RacoonDOEggs/hw_microRusEfi_usb_c/micro_rusEFI.kicad_pcb

## KiCad design micro_rusEFI.kicad_pcb (2025-06-24)

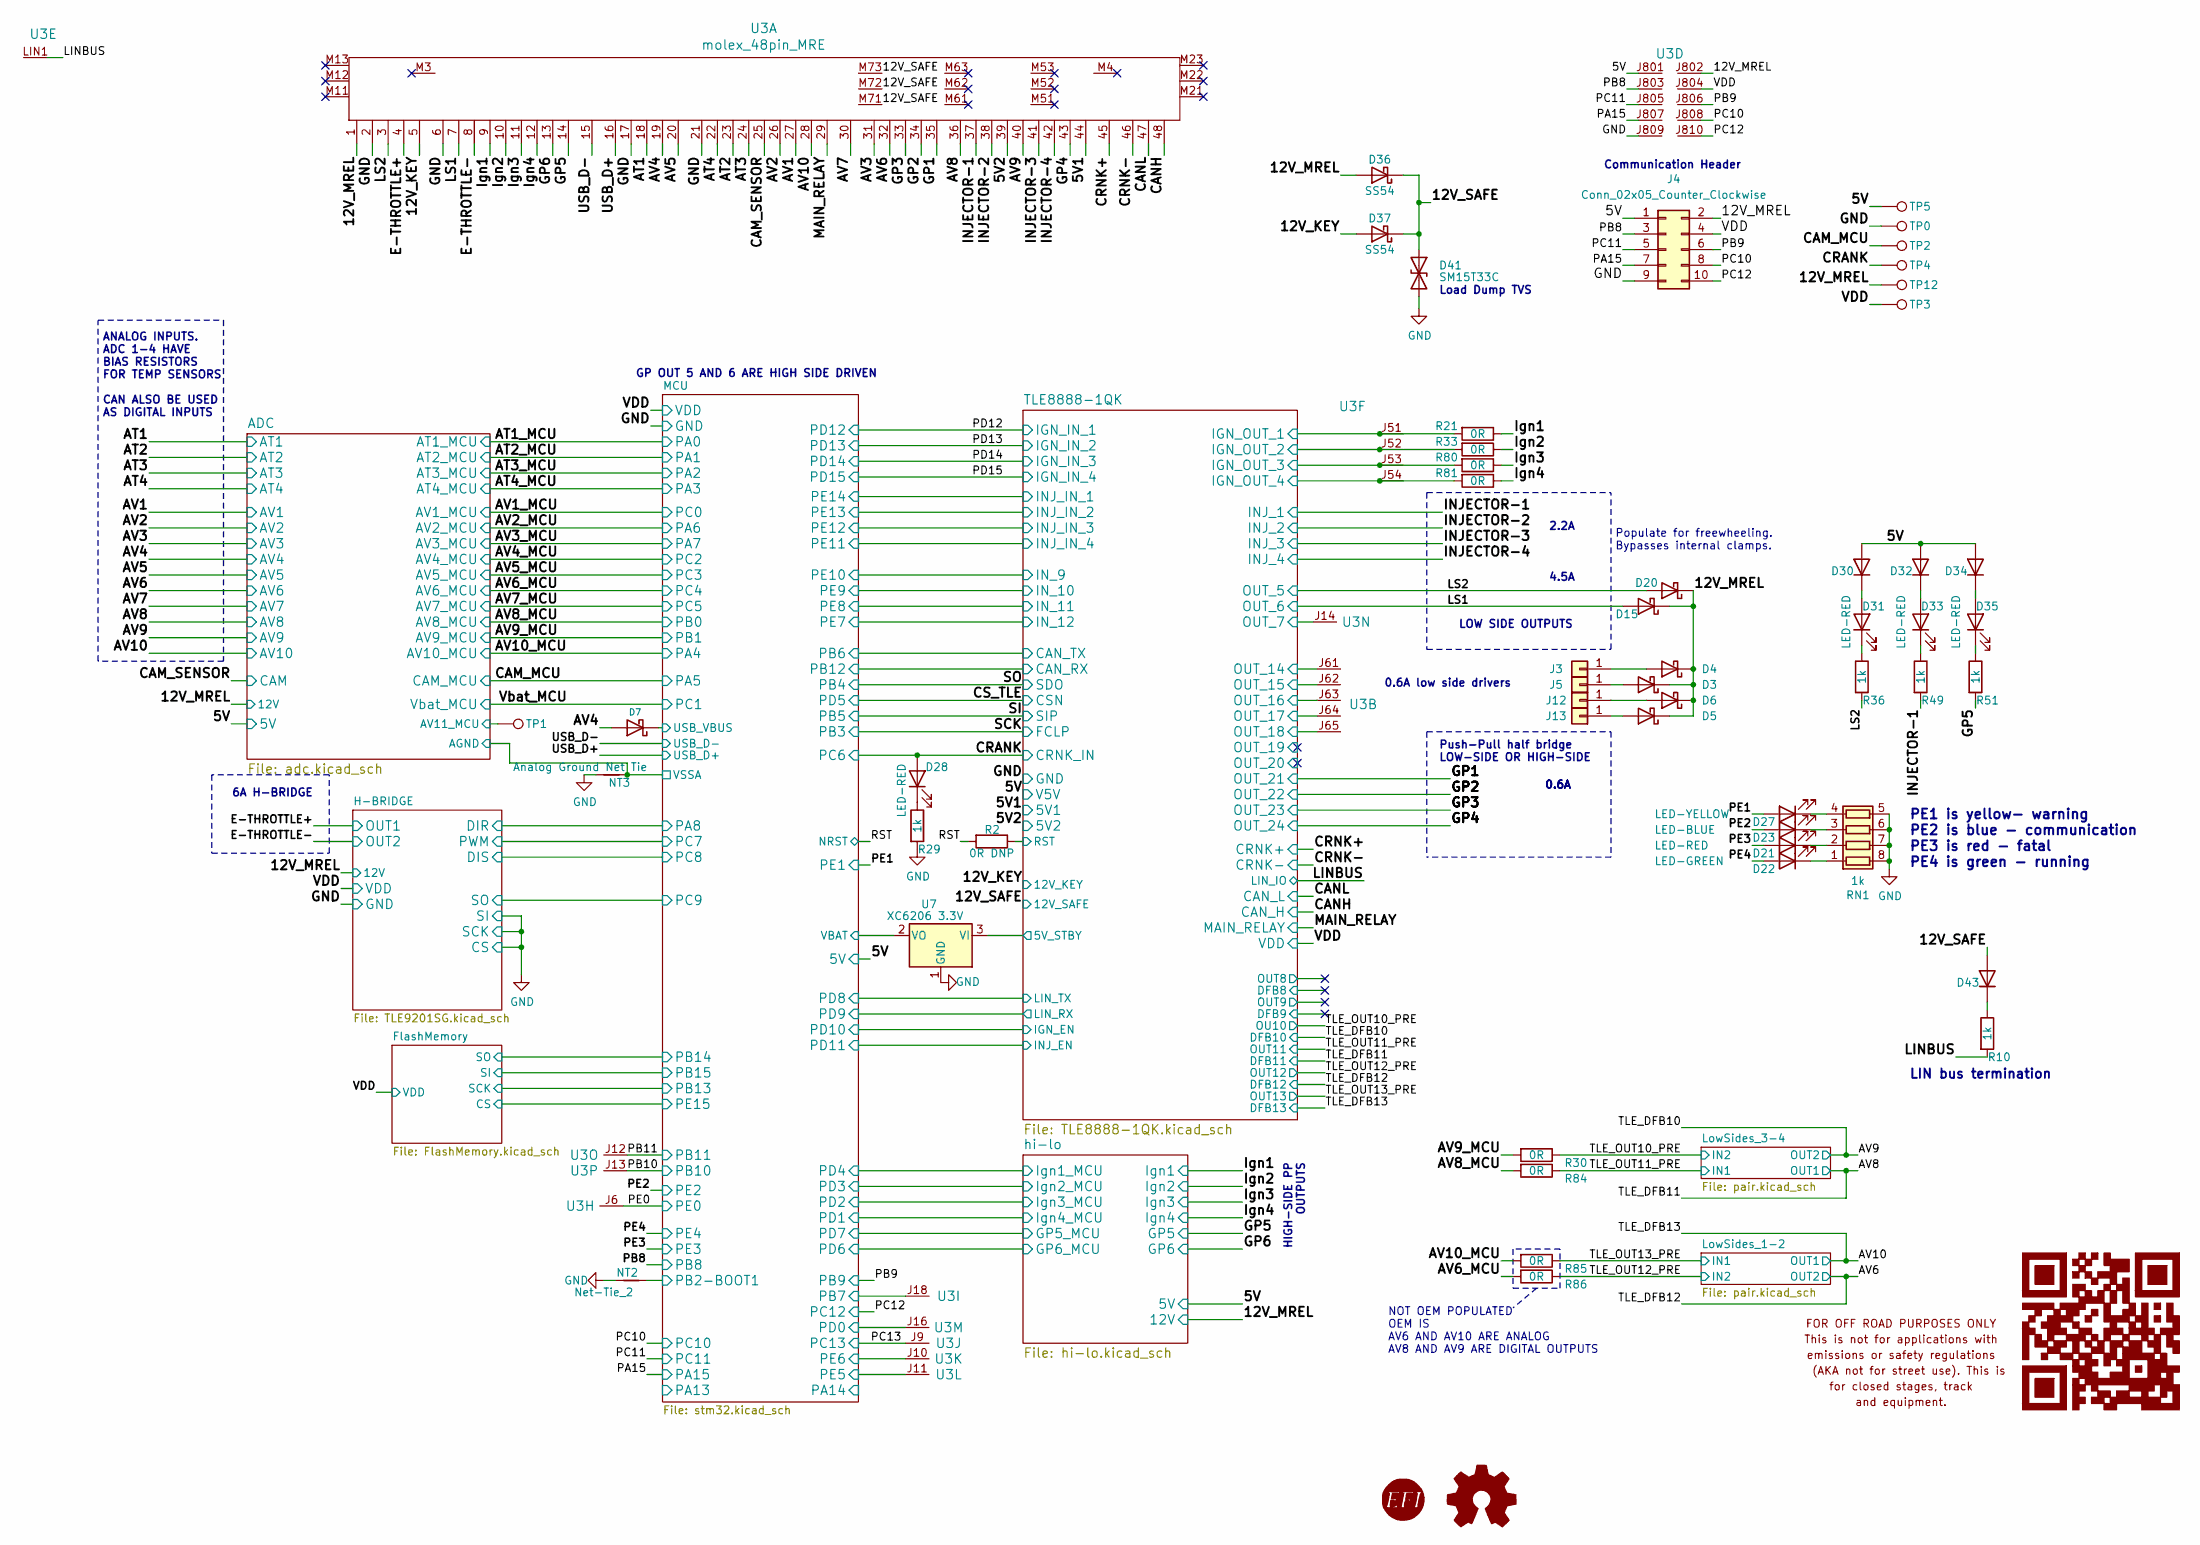
[picture p1: schematic micro_rusEFI.kicad_sch, microRusEFI-2L]

Parts:
D3, D4, D5, D6, D15, D20, D36, D37: SS54; D_SMA; LCSC C22452
D7: B5819W; D_SOD-123; LCSC C8598
D21: LED-RED; LED_0805_2012Metric; LCSC C84256
D22: LED-GREEN; LED_0805_2012Metric; LCSC C2297
D23: LED-BLUE; LED_0805_2012Metric; LCSC C2293
D27: LED-YELLOW; LED_0805_2012Metric; LCSC C2296
D28, D31, D33, D35: LED-RED; LED_0603_1608Metric; LCSC C2286
D30, D32, D34, D43: 1N4148WS; D_SOD-323; Part # NSR0530HT; LCSC C2128
D41: SM15T33C; D_SMC; LCSC C133707
G1: Disclaimer; Off_Road_Disclaimer
J3, J5, J12, J13: Conn_01x01; Pin_D0.7mm_L6.5mm_W1.8mm_FlatFork
J4: Conn_02x05_Counter_Clockwise; PinHeader_2x05_P2.54mm_Vertical_SMD
LOGO1: DNP; OSHW-Logo2_7.3x6mm_SilkScreen; Part # DNP
LOGO2: DNP; LOGO; Part # DNP
LOGO3: LOGO; MRE_QR_code
NT2: Net-Tie_2; Net-Tie_2_8.5mil
NT3: Analog Ground Net Tie; NetTie-2_SMD_Pad0.5mm
R2: 0R DNP; R_0603_1608Metric; Part # DNP
R10: 1k; R_1206_3216Metric; LCSC C4410
R21, R30, R33, R80, R81, R84: 0R; R_0603_1608Metric; Part # 0603WAF0000T5E; LCSC C21189
R29, R36, R49, R51: 1k; R_0603_1608Metric; Part # RMCF0603JJ1K00; LCSC C21190
R85: 0R; R_0603_1608Metric; Part # 0603WAF0000T5E
R86: 0R; R_0805_2012Metric
RN1: 1k; R_Array_Convex_4x0603; Part # CAT16-1001F4LF; LCSC C20197
TP0, TP3: GND; TestPoint_Pad_D2.0mm; Part # DNP
TP1, TP2, TP4: TP; TestPoint_Pad_D2.0mm; Part # DNP
TP5, TP12: 5V; TestPoint_Pad_D2.0mm; Part # DNP
U3: molex_48pin_MRE; Molex_48_MRE; Part # 500762-0481
U7: XC6206 3.3V; SOT-23; Part # XC6206P332MR; LCSC C5446

Connections:
/5V: D30.2 (A), D32.2 (A), D34.2 (A), J4.1, TP5.1, U3.J801; also elsewhere on the board
/5V1: U3.44; also elsewhere on the board
/5V2: U3.39; also elsewhere on the board
/12V_KEY: D37.2 (A), U3.5; also elsewhere on the board
/12V_MREL: D3.1 (K), D4.1 (K), D5.1 (K), D6.1 (K), D15.1 (K), D20.1 (K), D36.2 (A), J4.2, TP12.1, U3.1, U3.J802; also elsewhere on the board
/12V_SAFE: D36.1 (K), D37.1 (K), D41.1 (A1), D43.2 (A), U3.M71, U3.M72, U3.M73; also elsewhere on the board
/ADC/AGND: NT3.2; also elsewhere on the board
/ADC/AV11_MCU: TP1.1; also elsewhere on the board
/AT1: U3.18; also elsewhere on the board
/AT2: U3.23; also elsewhere on the board
/AT3: U3.24; also elsewhere on the board
/AT4: U3.22; also elsewhere on the board
/AV1: U3.27; also elsewhere on the board
/AV2: U3.26; also elsewhere on the board
/AV3: U3.31; also elsewhere on the board
/AV4: D7.2 (A), U3.19; also elsewhere on the board
/AV5: U3.20; also elsewhere on the board
/AV6: U3.32; also elsewhere on the board
/AV6_MCU: R86.2; also elsewhere on the board
/AV7: U3.30; also elsewhere on the board
/AV8: U3.36; also elsewhere on the board
/AV8_MCU: R84.2; also elsewhere on the board
/AV9: U3.40; also elsewhere on the board
/AV9_MCU: R30.2; also elsewhere on the board
/AV10: U3.28; also elsewhere on the board
/AV10_MCU: R85.2; also elsewhere on the board
/CAM_MCU: TP2.1; also elsewhere on the board
/CAM_SENSOR: U3.25; also elsewhere on the board
/CANH: U3.48; also elsewhere on the board
/CANL: U3.47; also elsewhere on the board
/CRANK: D28.2 (A), TP4.1; also elsewhere on the board
/CRNK+: U3.45; also elsewhere on the board
/CRNK-: U3.46; also elsewhere on the board
/E-THROTTLE+: U3.4; also elsewhere on the board
/E-THROTTLE-: U3.8; also elsewhere on the board
/GP1: U3.35; also elsewhere on the board
/GP2: U3.34; also elsewhere on the board
/GP3: U3.33; also elsewhere on the board
/GP4: U3.43; also elsewhere on the board
/GP5: R51.2, U3.14; also elsewhere on the board
/GP6: U3.13; also elsewhere on the board
/INJECTOR-1: R49.2, U3.37; also elsewhere on the board
/INJECTOR-2: U3.38; also elsewhere on the board
/INJECTOR-3: U3.41; also elsewhere on the board
/INJECTOR-4: U3.42; also elsewhere on the board
/Ign1: R21.1, U3.9; also elsewhere on the board
/Ign2: R33.1, U3.10; also elsewhere on the board
/Ign3: R80.1, U3.11; also elsewhere on the board
/Ign4: R81.1, U3.12; also elsewhere on the board
/LINBUS: R10.2, U3.LIN1; also elsewhere on the board
/LS1: D15.2 (A), U3.7; also elsewhere on the board
/LS2: D20.2 (A), R36.2, U3.3; also elsewhere on the board
/MAIN_RELAY: U3.29; also elsewhere on the board
/MCU/PB2-BOOT1: NT2.2; also elsewhere on the board
/MCU/PB7: U3.J18; also elsewhere on the board
/MCU/PD0: U3.J16; also elsewhere on the board
/MCU/PE5: U3.J11; also elsewhere on the board
/MCU/PE6: U3.J10; also elsewhere on the board
/MCU/VBAT: U7.2 (VO); also elsewhere on the board
/MCU/Vbus: D7.1 (K); also elsewhere on the board
/PA15: J4.7, U3.J807; also elsewhere on the board
/PB8: J4.3, U3.J803; also elsewhere on the board
/PB9: J4.6, U3.J806; also elsewhere on the board
/PB10: U3.J13; also elsewhere on the board
/PB11: U3.J12; also elsewhere on the board
/PC10: J4.8, U3.J808; also elsewhere on the board
/PC11: J4.5, U3.J805; also elsewhere on the board
/PC12: J4.10, U3.J810; also elsewhere on the board
/PC13: U3.J9; also elsewhere on the board
/PE0: U3.J6; also elsewhere on the board
/PE1: D27.2 (A); also elsewhere on the board
/PE2: D23.2 (A); also elsewhere on the board
/PE3: D21.2 (A); also elsewhere on the board
/PE4: D22.2 (A); also elsewhere on the board
/RST: R2.2; also elsewhere on the board
/TLE8888-1QK/5V_STBY: U7.3 (VI); also elsewhere on the board
/TLE8888-1QK/IGN_OUT_1: R21.2, U3.J51; also elsewhere on the board
/TLE8888-1QK/IGN_OUT_2: R33.2, U3.J52; also elsewhere on the board
/TLE8888-1QK/IGN_OUT_3: R80.2, U3.J53; also elsewhere on the board
/TLE8888-1QK/IGN_OUT_4: R81.2, U3.J54; also elsewhere on the board
/TLE8888-1QK/OUT_7: U3.J14; also elsewhere on the board
/TLE8888-1QK/OUT_14: U3.J61; also elsewhere on the board
/TLE8888-1QK/OUT_15: U3.J62; also elsewhere on the board
/TLE8888-1QK/OUT_16: U3.J63; also elsewhere on the board
/TLE8888-1QK/OUT_17: U3.J64; also elsewhere on the board
/TLE8888-1QK/OUT_18: U3.J65; also elsewhere on the board
/TLE8888-1QK/RST: R2.1; also elsewhere on the board
/TLE_OUT10_PRE: R30.1; also elsewhere on the board
/TLE_OUT11_PRE: R84.1; also elsewhere on the board
/TLE_OUT12_PRE: R86.1; also elsewhere on the board
/TLE_OUT13_PRE: R85.1; also elsewhere on the board
/USB_D+: U3.16; also elsewhere on the board
/USB_D-: U3.15; also elsewhere on the board
/VDD: J4.4, TP3.1, U3.J804; also elsewhere on the board
GND: D41.2 (A2), J4.9, NT2.1, NT3.1, R29.2, RN1.5 (R4.2), RN1.6 (R3.2), RN1.7 (R2.2), RN1.8 (R1.2), TP0.1, U3.2, U3.6, U3.17, U3.21, U3.J809, U7.1 (GND); also elsewhere on the board
unnamed: D3.2 (A), J5.1
unnamed: D4.2 (A), J3.1
unnamed: D5.2 (A), J13.1
unnamed: D6.2 (A), J12.1
unnamed: D21.1 (K), RN1.2 (R2.1)
unnamed: D22.1 (K), RN1.1 (R1.1)
unnamed: D23.1 (K), RN1.3 (R3.1)
unnamed: D27.1 (K), RN1.4 (R4.1)
unnamed: D28.1 (K), R29.1
unnamed: D30.1 (K), D31.2 (A)
unnamed: D31.1 (K), R36.1
unnamed: D32.1 (K), D33.2 (A)
unnamed: D33.1 (K), R49.1
unnamed: D34.1 (K), D35.2 (A)
unnamed: D35.1 (K), R51.1
unnamed: D43.1 (K), R10.1

Notes on the sheet:
GP OUT 5 AND 6 ARE HIGH SIDE DRIVEN
6A H-BRIDGE
Load Dump TVS
0.6A
0.6A low side drivers
NOT OEM POPULATED OEM IS AV6 AND AV10 ARE ANALOG AV8 AND AV9 ARE DIGITAL OUTPUTS
Communication Header
ANALOG INPUTS. ADC 1-4 HAVE BIAS RESISTORS FOR TEMP SENSORS CAN ALSO BE USED AS DIGITAL INPUTS
LOW SIDE OUTPUTS
Push-Pull half bridge LOW-SIDE OR HIGH-SIDE
4.5A
PE1 is yellow- warning PE2 is blue - communication PE3 is red - fatal PE4 is green - running
HIGH-SIDE PP OUTPUTS
Populate for freewheeling. Bypasses internal clamps.
2.2A
LIN bus termination

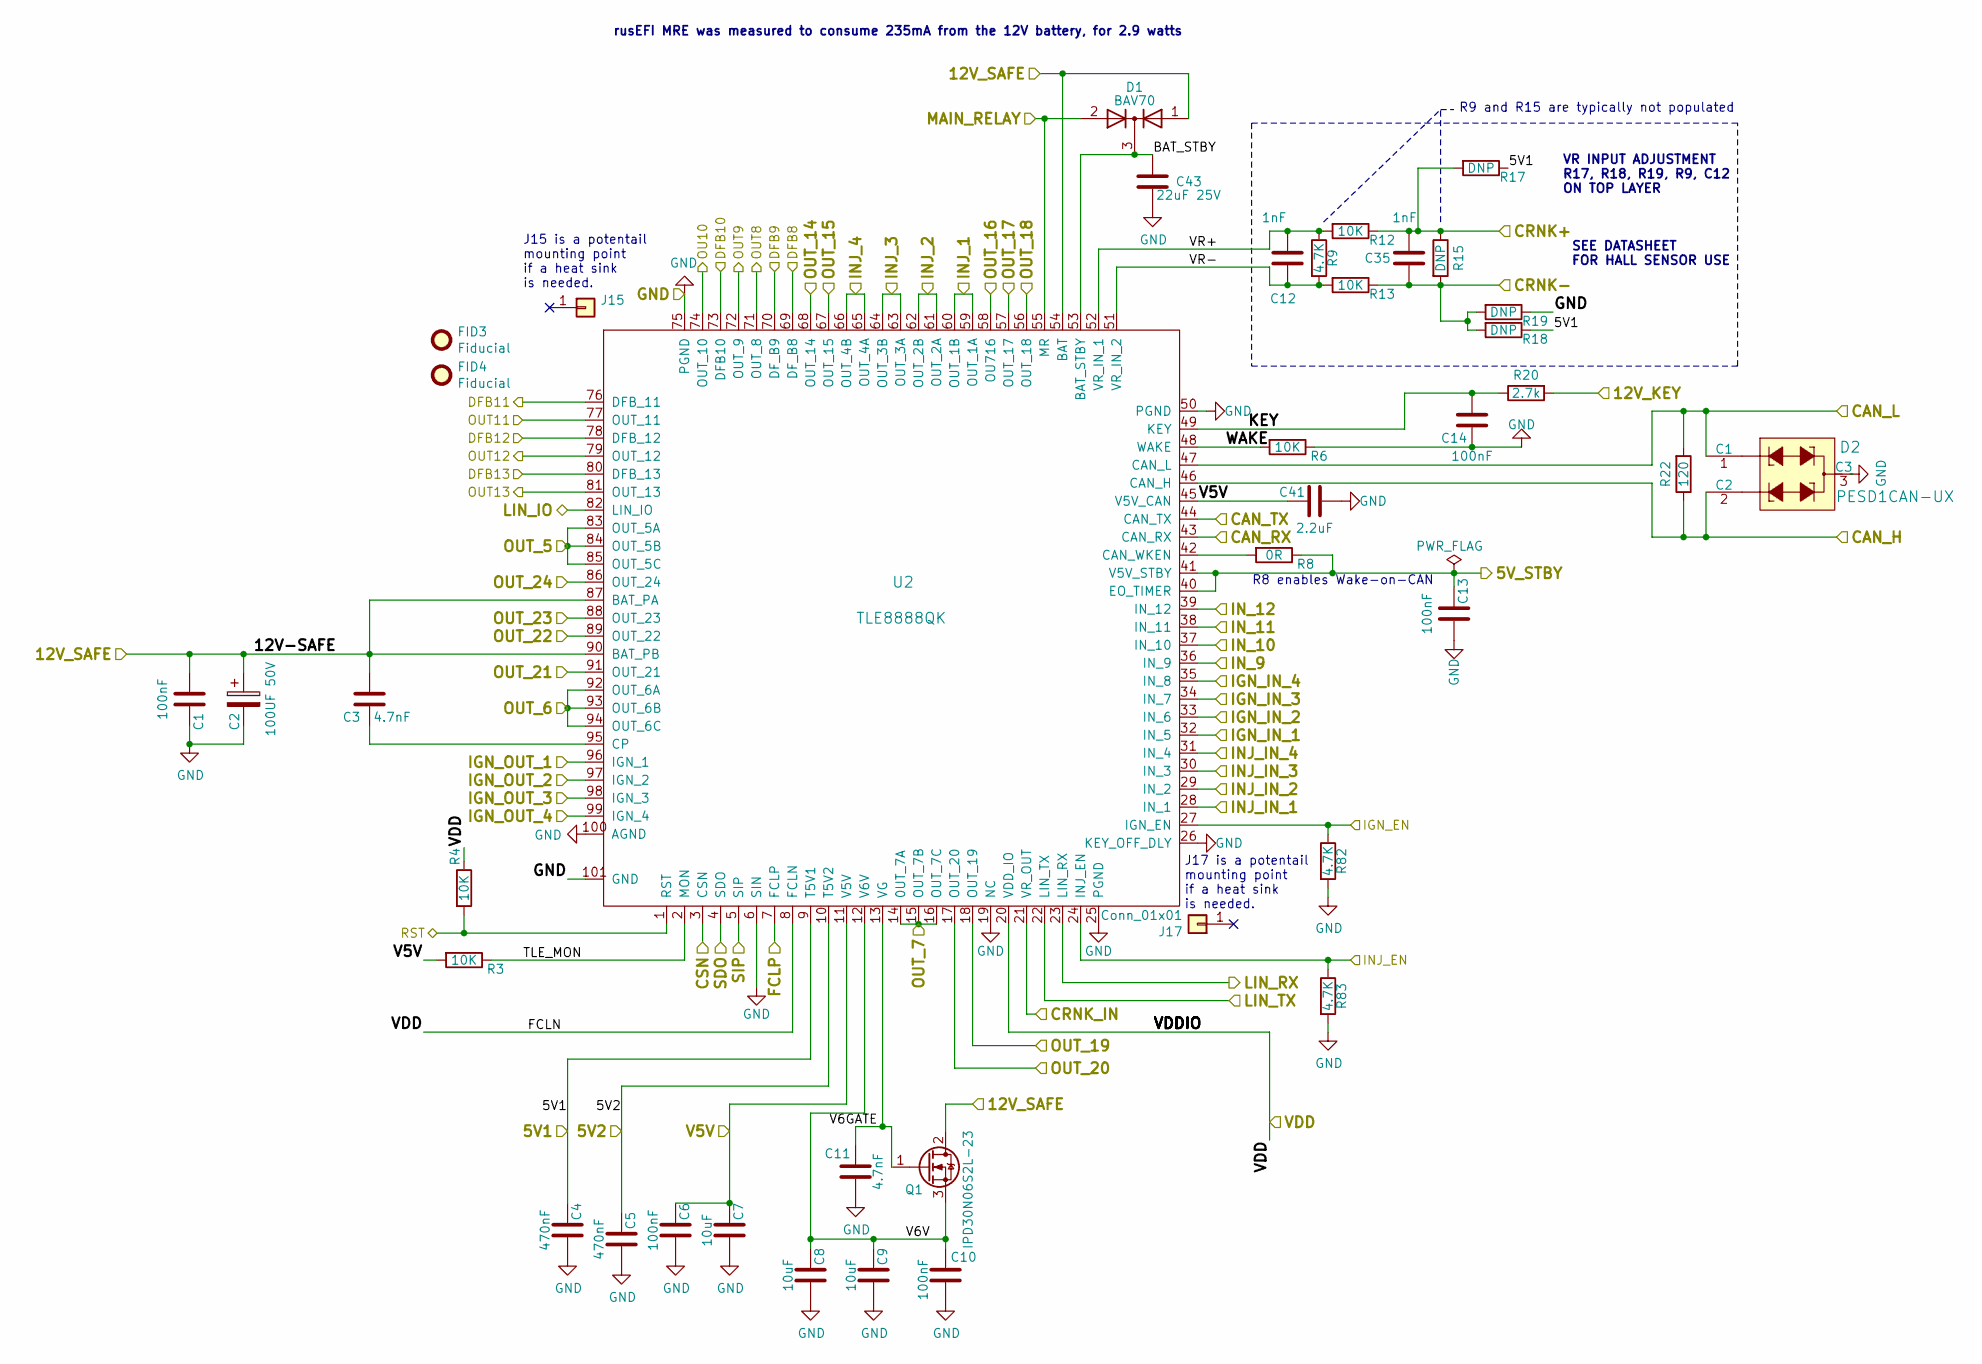
[picture p2: schematic TLE8888-1QK.kicad_sch, microRusEFI-2L]

Parts:
C1, C6, C10, C13, C14: 100nF; C_0603_1608Metric; Part # C0603C104J5RACTU; LCSC C14663
C2: 100UF 50V; CP_Elec_8x10.5; Part # UCD1H101MNL1GS; LCSC C134515
C3, C11: 4.7nF; C_0603_1608Metric; Part # CGA3E2X7R1H472K080AA; LCSC C53987
C4, C5: 470nF; C_0603_1608Metric; Part # CGA3E3X7R1H474K080AE; LCSC C1623
C7, C8, C9: 10uF; C_0603_1608Metric; Part # C1608X5R1E106M080AC; LCSC C19702
C12, C35: 1nF; C_0603_1608Metric; Part # GRM1885C1H102FA01D; LCSC C1588
C41: 2.2uF; C_0603_1608Metric; Part # GRM188R6YA225KA12D; LCSC C23630
C43: 22uF 25V; C_0805_2012Metric; Part # CL21A226MAQNNNE; LCSC C45783
D1: BAV70; SOT-23; LCSC C82479
D2: PESD1CAN-UX; SOT-23; Part # PESD1CANUX; LCSC C152727
FID3, FID4: Fiducial; Fiducial_0.5mm_Mask1mm; Part # DNP
J15, J17: Conn_01x01; Pin_D0.7mm_L6.5mm_W1.8mm_FlatFork
Q1: IPD30N06S2L-23; TO-252-2; Part # IPD30N06S2L23AT3; LCSC C3010
R3: 10K; R_0805_2012Metric; LCSC C17414
R4, R6, R12, R13: 10K; R_0603_1608Metric; Part # RMCF0603JT10K0; LCSC C25804
R8: 0R; R_0603_1608Metric; Part # 0603WAF0000T5E; LCSC C21189
R9: 4.7K; R_0603_1608Metric; Part # RMCF0603JT4K70; LCSC DNP
R15, R17, R18, R19: DNP; R_0603_1608Metric; Part # DNP
R20: 2.7k; R_0603_1608Metric; Part # RMCF0603FT2K70; LCSC C13167
R22: 120; R_0805_2012Metric; LCSC C17437
R82, R83: 4.7K; R_0603_1608Metric; Part # RMCF0603JT4K70; LCSC C23162
U2: TLE8888QK; LQFP-100_14x14mm_P0.5mm_THERMAL; Part # TLE88882QKXUMA1

Connections:
/5V: C6.1, C7.1, C41.1, R3.2, U2.11 (V5V), U2.45 (V5V_CAN); also elsewhere on the board
/5V1: C4.1, R17.1, R18.1, U2.9 (T5V1); also elsewhere on the board
/5V2: C5.1, U2.10 (T5V2); also elsewhere on the board
/12V_KEY: R20.2; also elsewhere on the board
/12V_SAFE: C1.1, C2.1, C3.1, D1.1 (A), Q1.2 (D), U2.54 (BAT), U2.87 (BAT_PA), U2.90 (BAT_PB); also elsewhere on the board
/AV6: U2.78 (DFB_12); also elsewhere on the board
/AV8: U2.76 (DFB_11); also elsewhere on the board
/AV9: U2.73 (DFB10); also elsewhere on the board
/AV10: U2.80 (DFB_13); also elsewhere on the board
/CANH: D2.2 (C2), R22.1, U2.46 (CAN_H); also elsewhere on the board
/CANL: D2.1 (C1), R22.2, U2.47 (CAN_L); also elsewhere on the board
/CRANK: U2.21 (VR_OUT); also elsewhere on the board
/CRNK+: C35.1, R12.1, R15.1, R17.2; also elsewhere on the board
/CRNK-: C35.2, R13.1, R15.2, R18.2, R19.2; also elsewhere on the board
/CS_TLE: U2.3 (CSN); also elsewhere on the board
/GP1: U2.91 (OUT_21); also elsewhere on the board
/GP2: U2.89 (OUT_22); also elsewhere on the board
/GP3: U2.88 (OUT_23); also elsewhere on the board
/GP4: U2.86 (OUT_24); also elsewhere on the board
/INJECTOR-1: U2.59 (OUT_1A), U2.60 (OUT_1B); also elsewhere on the board
/INJECTOR-2: U2.61 (OUT_2A), U2.62 (OUT_2B); also elsewhere on the board
/INJECTOR-3: U2.63 (OUT_3A), U2.64 (OUT_3B); also elsewhere on the board
/INJECTOR-4: U2.65 (OUT_4A), U2.66 (OUT_4B); also elsewhere on the board
/LINBUS: U2.82 (LIN_IO); also elsewhere on the board
/LS1: U2.92 (OUT_6A), U2.93 (OUT_6B), U2.94 (OUT_6C); also elsewhere on the board
/LS2: U2.83 (OUT_5A), U2.84 (OUT_5B), U2.85 (OUT_5C); also elsewhere on the board
/MAIN_RELAY: D1.2 (A), U2.55 (MR); also elsewhere on the board
/MCU/PB6: U2.44 (CAN_TX); also elsewhere on the board
/MCU/PB12: U2.43 (CAN_RX); also elsewhere on the board
/MCU/PD8: U2.22 (LIN_TX); also elsewhere on the board
/MCU/PD9: U2.23 (LIN_RX); also elsewhere on the board
/MCU/PD10: R82.1, U2.27 (IGN_EN); also elsewhere on the board
/MCU/PD11: R83.1, U2.24 (INJ_EN); also elsewhere on the board
/MCU/PE7: U2.39 (IN_12); also elsewhere on the board
/MCU/PE8: U2.38 (IN_11); also elsewhere on the board
/MCU/PE9: U2.37 (IN_10); also elsewhere on the board
/MCU/PE10: U2.36 (IN_9); also elsewhere on the board
/MCU/PE11: U2.31 (IN_4); also elsewhere on the board
/MCU/PE12: U2.30 (IN_3); also elsewhere on the board
/MCU/PE13: U2.29 (IN_2); also elsewhere on the board
/MCU/PE14: U2.28 (IN_1); also elsewhere on the board
/PD12: U2.32 (IN_5); also elsewhere on the board
/PD13: U2.33 (IN_6); also elsewhere on the board
/PD14: U2.34 (IN_7); also elsewhere on the board
/PD15: U2.35 (IN_8); also elsewhere on the board
/SCK: U2.7 (FCLP); also elsewhere on the board
/SI: U2.5 (SIP); also elsewhere on the board
/SO: U2.4 (SDO); also elsewhere on the board
/TLE8888-1QK/5V_STBY: C13.1, R8.1, U2.40 (EO_TIMER), U2.41 (V5V_STBY); also elsewhere on the board
/TLE8888-1QK/BAT_STBY: C43.1, D1.3 (K), U2.53 (BAT_STBY)
/TLE8888-1QK/DFB8: U2.69 (DF_B8)
/TLE8888-1QK/DFB9: U2.70 (DF_B9)
/TLE8888-1QK/IGN_OUT_1: U2.96 (IGN_1); also elsewhere on the board
/TLE8888-1QK/IGN_OUT_2: U2.97 (IGN_2); also elsewhere on the board
/TLE8888-1QK/IGN_OUT_3: U2.98 (IGN_3); also elsewhere on the board
/TLE8888-1QK/IGN_OUT_4: U2.99 (IGN_4); also elsewhere on the board
/TLE8888-1QK/KEY: C14.1, R20.1, U2.49 (KEY)
/TLE8888-1QK/OUT8: U2.71 (OUT_8)
/TLE8888-1QK/OUT9: U2.72 (OUT_9)
/TLE8888-1QK/OUT_7: U2.14 (0UT_7A), U2.15 (OUT_7B), U2.16 (OUT_7C); also elsewhere on the board
/TLE8888-1QK/OUT_14: U2.68 (OUT_14); also elsewhere on the board
/TLE8888-1QK/OUT_15: U2.67 (OUT_15); also elsewhere on the board
/TLE8888-1QK/OUT_16: U2.58 (OU716); also elsewhere on the board
/TLE8888-1QK/OUT_17: U2.57 (OUT_17); also elsewhere on the board
/TLE8888-1QK/OUT_18: U2.56 (OUT_18); also elsewhere on the board
/TLE8888-1QK/OUT_19: U2.18 (OUT_19)
/TLE8888-1QK/OUT_20: U2.17 (OUT_20)
/TLE8888-1QK/RST: R4.2, U2.1 (RST); also elsewhere on the board
/TLE8888-1QK/TLE_MON: R3.1, U2.2 (MON)
/TLE8888-1QK/V6GATE: C11.1, Q1.1 (G), U2.13 (VG)
/TLE8888-1QK/V6V: C8.1, C9.1, C10.1, Q1.3 (S), U2.12 (V6V)
/TLE8888-1QK/VR+: C12.1, R9.1, R12.2, U2.52 (VR_IN_1)
/TLE8888-1QK/VR-: C12.2, R9.2, R13.2, U2.51 (VR_IN_2)
/TLE8888-1QK/WAKE: R6.2, U2.48 (WAKE)
/TLE_OUT10_PRE: U2.74 (OUT_10); also elsewhere on the board
/TLE_OUT11_PRE: U2.77 (OUT_11); also elsewhere on the board
/TLE_OUT12_PRE: U2.79 (OUT_12); also elsewhere on the board
/TLE_OUT13_PRE: U2.81 (OUT_13); also elsewhere on the board
/VDD: R4.1, U2.8 (FCLN), U2.20 (VDD_IO); also elsewhere on the board
GND: C1.2, C2.2, C4.2, C5.2, C6.2, C7.2, C8.2, C9.2, C10.2, C11.2, C13.2, C14.2, C41.2, C43.2, D2.3 (C3), R6.1, R19.1, R82.2, R83.2, U2.6 (SIN), U2.19 (NC), U2.25 (PGND), U2.26 (KEY_OFF_DLY), U2.50 (PGND), U2.75 (PGND), U2.100 (AGND), U2.101 (GND); also elsewhere on the board
unnamed: R8.2, U2.42 (CAN_WKEN)
unnamed: C3.2, U2.95 (CP)

Notes on the sheet:
J15 is a potentail mounting point if a heat sink is needed.
rusEFI MRE was measured to consume 235mA from the 12V battery, for 2.9 watts
J17 is a potentail mounting point if a heat sink is needed.
R8 enables Wake-on-CAN
R9 and R15 are typically not populated
VR INPUT ADJUSTMENT R17, R18, R19, R9, C12 ON TOP LAYER
SEE DATASHEET FOR HALL SENSOR USE

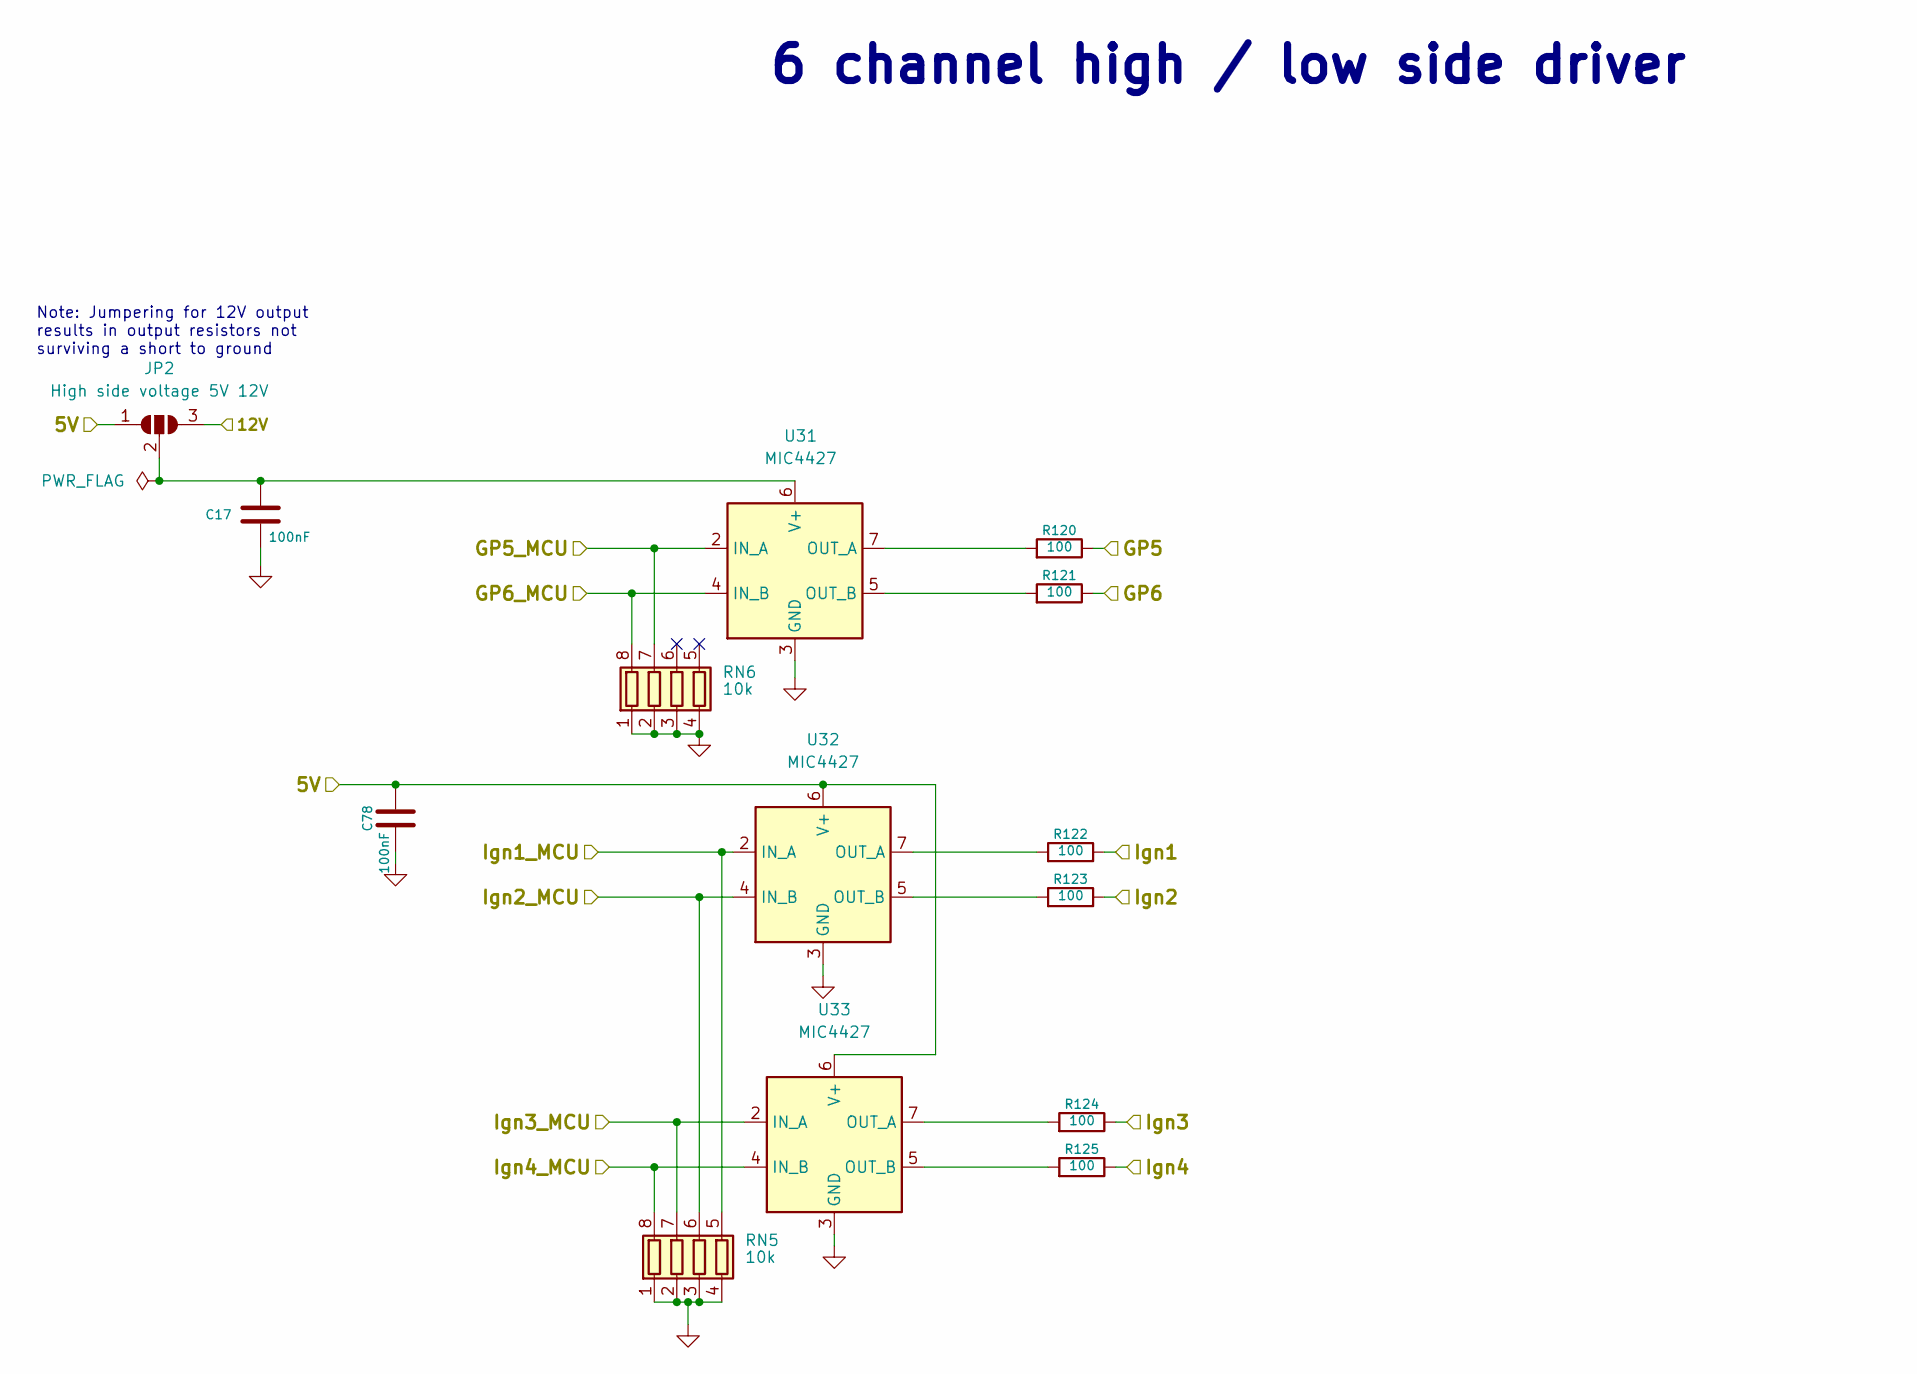
[picture p3: schematic hi-lo.kicad_sch, microRusEFI-2L]

Parts:
C17, C78: 100nF; C_0603_1608Metric; Part # C0603C104J5RACTU; LCSC C14663
JP2: High side voltage 5V 12V; SolderJumper-3_P1.3mm_Open_Pad1.0x1.5mm
R120, R121, R122, R123, R124, R125: 100; R_1206_3216Metric; Part # RMCF0603FT100R; LCSC C17901
RN5, RN6: 10k; R_Array_Convex_4x0603; Part # YC164-JR-0710KL; LCSC C29718
U31, U32, U33: MIC4427; SOIC-8_3.9x4.9mm_P1.27mm; LCSC C144205

Connections:
/5V: C78.1, JP2.1 (A), U32.6 (V+), U33.6 (V+); also elsewhere on the board
/12V_MREL: JP2.3 (B); also elsewhere on the board
/GP5: R120.1; also elsewhere on the board
/GP6: R121.1; also elsewhere on the board
/Ign1: R122.1; also elsewhere on the board
/Ign2: R123.1; also elsewhere on the board
/Ign3: R124.1; also elsewhere on the board
/Ign4: R125.1; also elsewhere on the board
/MCU/PD1: RN5.8 (R1.2), U33.4 (IN_B); also elsewhere on the board
/MCU/PD2: RN5.7 (R2.2), U33.2 (IN_A); also elsewhere on the board
/MCU/PD3: RN5.6 (R3.2), U32.4 (IN_B); also elsewhere on the board
/MCU/PD4: RN5.5 (R4.2), U32.2 (IN_A); also elsewhere on the board
/MCU/PD6: RN6.8 (R1.2), U31.4 (IN_B); also elsewhere on the board
/MCU/PD7: RN6.7 (R2.2), U31.2 (IN_A); also elsewhere on the board
GND: C17.2, C78.2, RN5.1 (R1.1), RN5.2 (R2.1), RN5.3 (R3.1), RN5.4 (R4.1), RN6.1 (R1.1), RN6.2 (R2.1), RN6.3 (R3.1), RN6.4 (R4.1), U31.3 (GND), U32.3 (GND), U33.3 (GND); also elsewhere on the board
unnamed: C17.1, JP2.2 (C), U31.6 (V+)
unnamed: R120.2, U31.7 (OUT_A)
unnamed: R121.2, U31.5 (OUT_B)
unnamed: R122.2, U32.7 (OUT_A)
unnamed: R123.2, U32.5 (OUT_B)
unnamed: R124.2, U33.7 (OUT_A)
unnamed: R125.2, U33.5 (OUT_B)

Notes on the sheet:
Note: Jumpering for 12V output results in output resistors not surviving a short to ground
6 channel high / low side driver
