RacoonDOEggs/hw_microRusEfi_usb_c/micro_rusEFI.kicad_pcb

## KiCad design micro_rusEFI.kicad_pcb (continued)

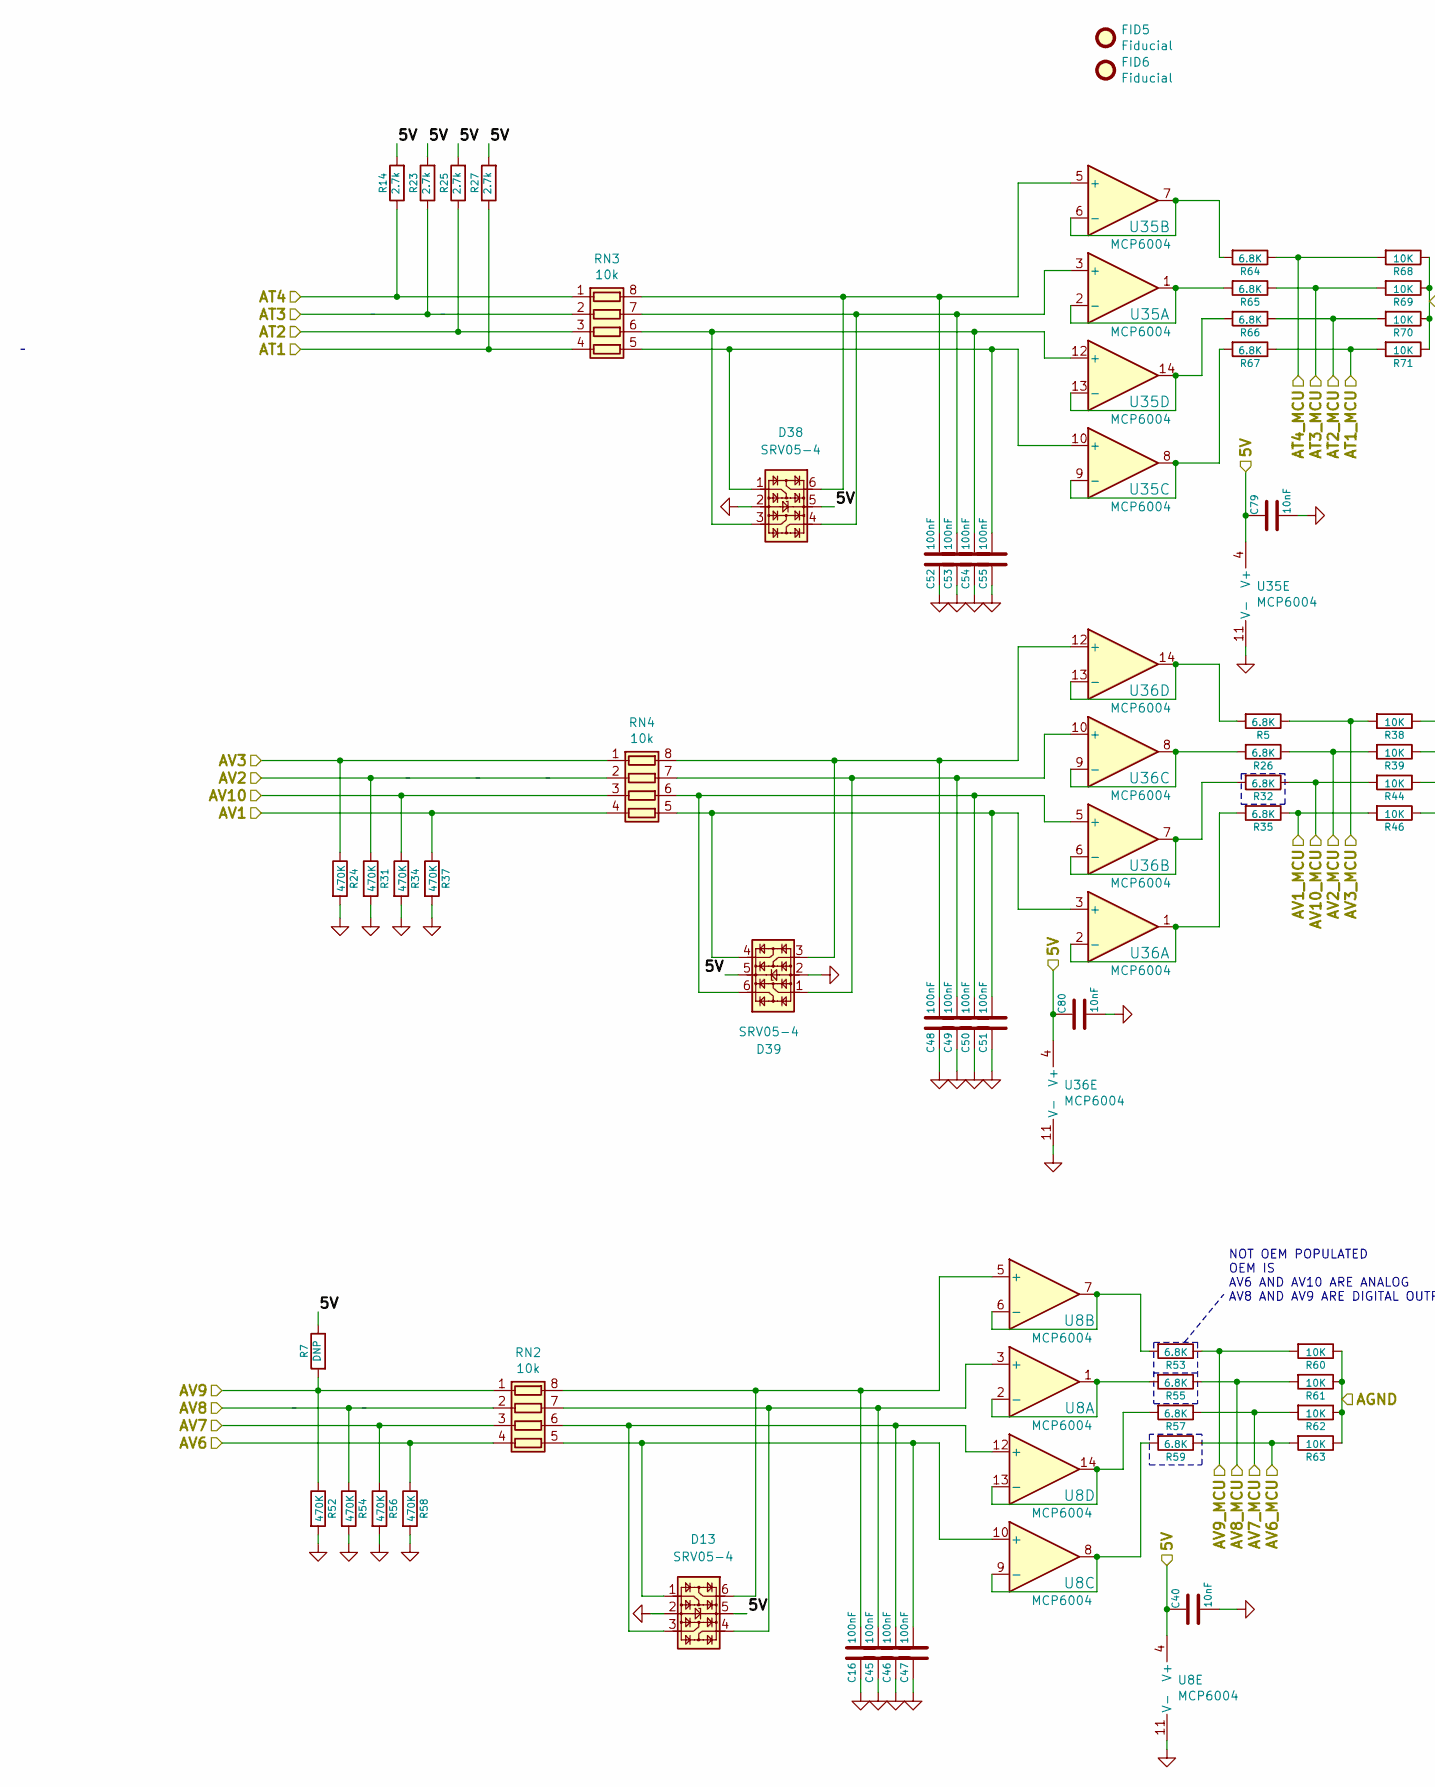
[picture p4: schematic adc.kicad_sch, microRusEFI-2L, part in row 1, column 1]

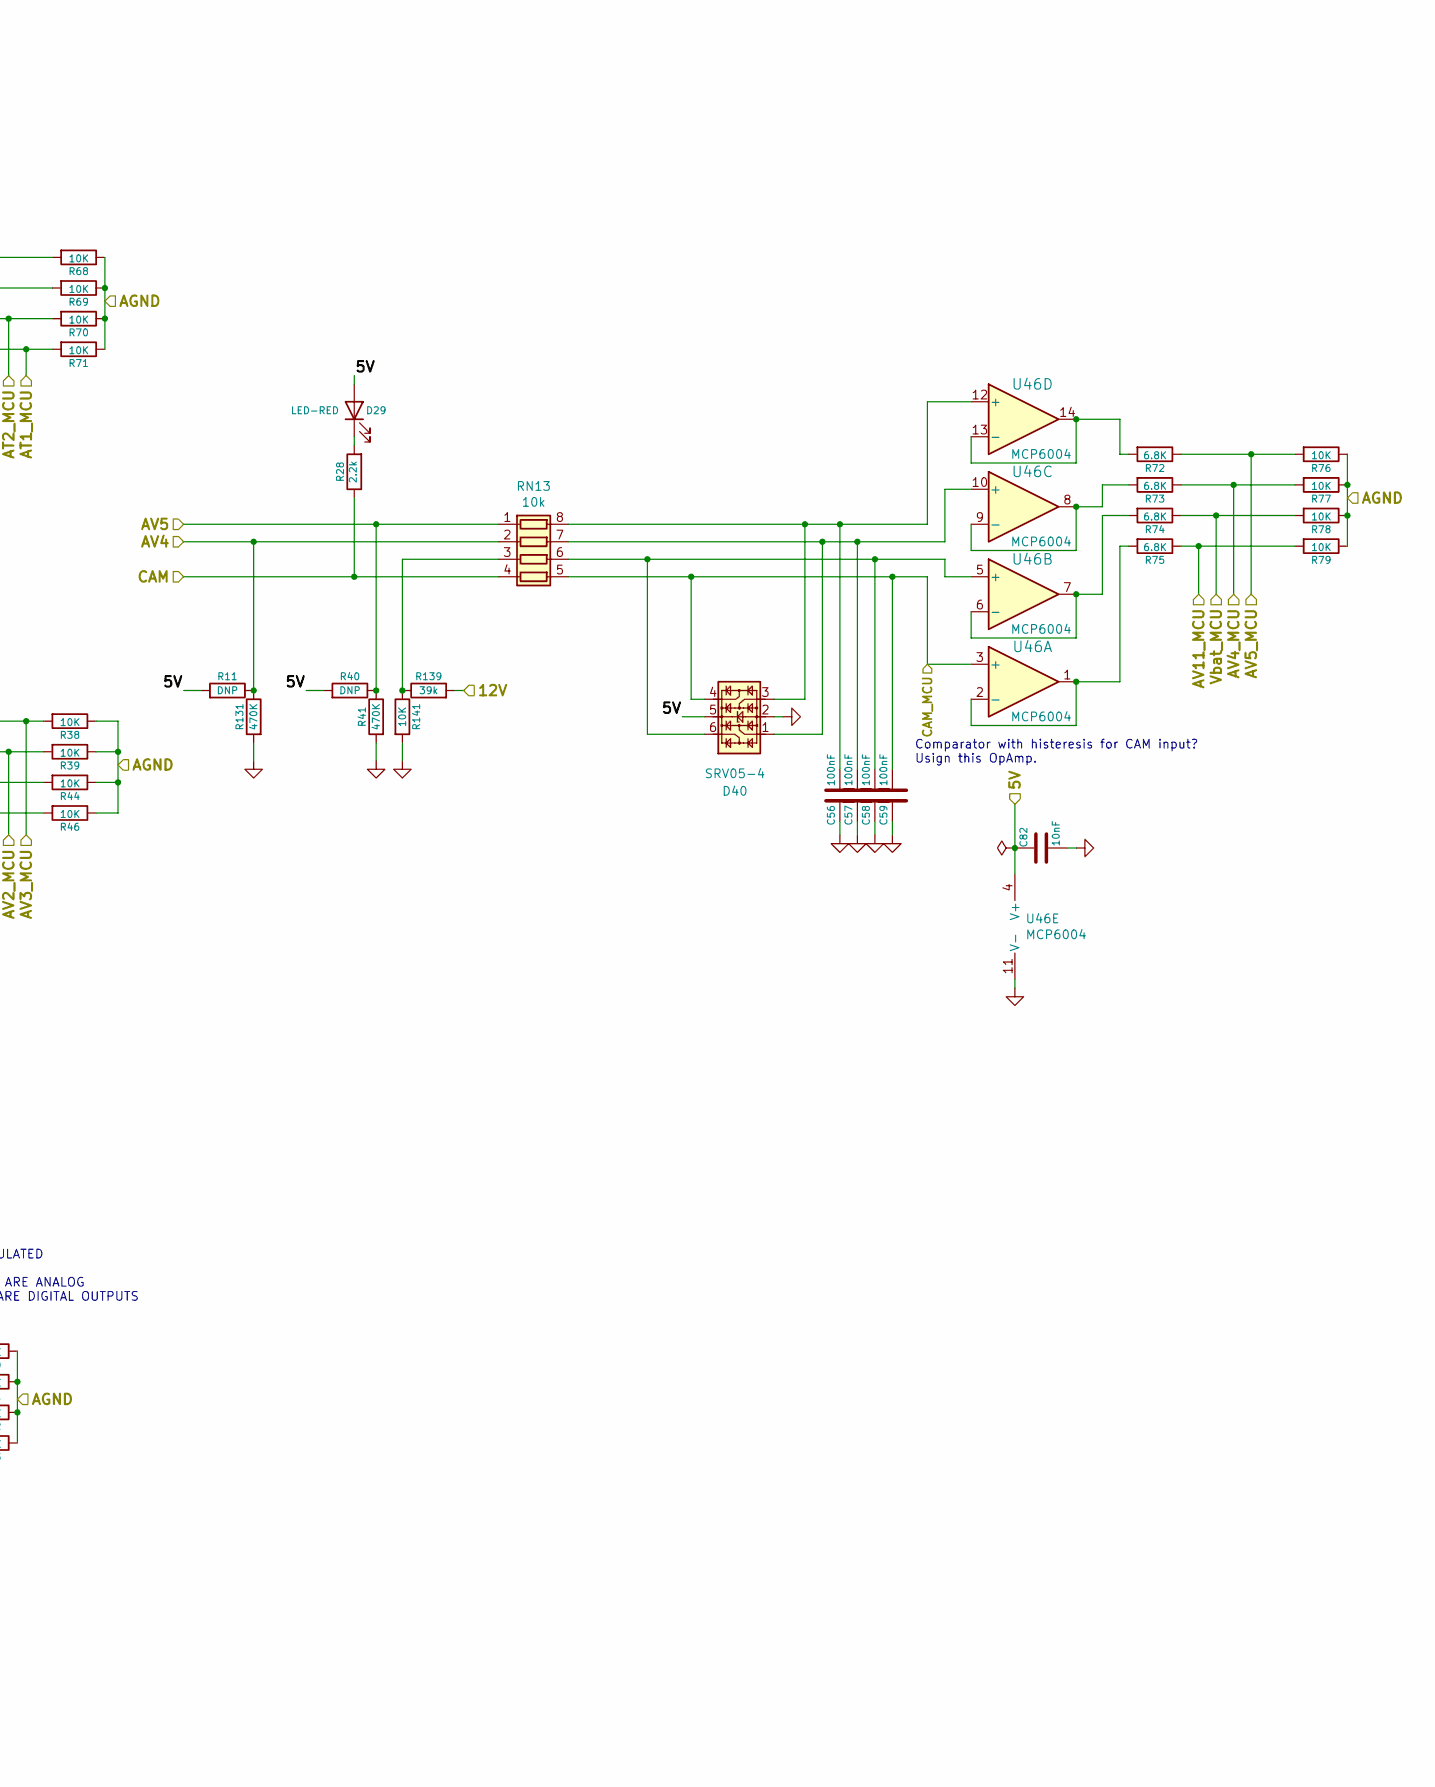
[picture p5: schematic adc.kicad_sch, microRusEFI-2L, part in row 1, column 2]

Parts:
C16, C45, C46, C47, C48, C49, C50, C51, C52, C53, C54, C55, C56, C57, C58, C59: 100nF; C_0402_1005Metric; LCSC C1525
C40, C79, C80, C82: 10nF; C_0603_1608Metric; Part # C0603C103K1RACTU; LCSC C57112
D13, D38, D39, D40: SRV05-4; SOT-23-6; LCSC C85364
D29: LED-RED; LED_0603_1608Metric; LCSC C2286
FID5, FID6: Fiducial; Fiducial_0.5mm_Mask1mm; Part # DNP
R5, R26, R32, R35, R57, R59, R64, R65, R66, R67, R72, R73, R74, R75: 6.8K; R_0603_1608Metric; LCSC C23212
R7, R11, R40: DNP; R_0402_1005Metric; Part # DNP
R14, R23, R25, R27: 2.7k; R_0603_1608Metric; Part # RMCF0603FT2K70; LCSC C13167
R24, R31, R34, R37, R41, R52, R54, R56, R58, R131: 470K; R_0402_1005Metric; LCSC C25790
R28: 2.2k; R_0603_1608Metric; Part # RMCF0603FT2K20; LCSC C4190
R38, R39, R44, R46, R60, R61, R62, R63, R68, R69, R70, R71, R76, R77, R78, R79, R141: 10K; R_0603_1608Metric; Part # RMCF0603JT10K0; LCSC C25804
R53, R55: 6.8K; R_0603_1608Metric
R139: 39k; R_0603_1608Metric; Part # RC0603FR-0739KL; LCSC C23153
RN2, RN3, RN4, RN13: 10k; R_Array_Convex_4x0603; Part # YC164-JR-0710KL; LCSC C29718
U8, U35, U36, U46: MCP6004; TSSOP-14_4.4x5mm_P0.65mm; Part # MCP6004T-I/ST; LCSC C248577

Connections:
/5V: C40.1, C79.1, C80.1, C82.1, D13.5, D29.2 (A), D38.5, D39.5, D40.5, R7.1, R11.2, R14.2, R23.2, R25.2, R27.2, R40.2, U8.4 (V+), U35.4 (V+), U36.4 (V+), U46.4 (V+); also elsewhere on the board
/12V_MREL: R139.2; also elsewhere on the board
/ADC/AGND: R38.1, R39.1, R44.1, R46.1, R60.1, R61.1, R62.1, R63.1, R68.1, R69.1, R70.1, R71.1, R76.1, R77.1, R78.1, R79.1; also elsewhere on the board
/ADC/AV11_MCU: R75.1, R79.2; also elsewhere on the board
/AT1: R27.1, RN3.4 (R4.1); also elsewhere on the board
/AT1_MCU: R67.1, R71.2; also elsewhere on the board
/AT2: R25.1, RN3.3 (R3.1); also elsewhere on the board
/AT2_MCU: R66.1, R70.2; also elsewhere on the board
/AT3: R23.1, RN3.2 (R2.1); also elsewhere on the board
/AT3_MCU: R65.1, R69.2; also elsewhere on the board
/AT4: R14.1, RN3.1 (R1.1); also elsewhere on the board
/AT4_MCU: R64.1, R68.2; also elsewhere on the board
/AV1: R37.1, RN4.4 (R4.1); also elsewhere on the board
/AV1_MCU: R35.1, R46.2; also elsewhere on the board
/AV2: R31.1, RN4.2 (R2.1); also elsewhere on the board
/AV2_MCU: R26.1, R39.2; also elsewhere on the board
/AV3: R24.1, RN4.1 (R1.1); also elsewhere on the board
/AV3_MCU: R5.1, R38.2; also elsewhere on the board
/AV4: R11.1, R131.1, RN13.2 (R2.1); also elsewhere on the board
/AV4_MCU: R73.1, R77.2; also elsewhere on the board
/AV5: R40.1, R41.1, RN13.1 (R1.1); also elsewhere on the board
/AV5_MCU: R72.1, R76.2; also elsewhere on the board
/AV6: R58.1, RN2.4 (R4.1); also elsewhere on the board
/AV6_MCU: R59.1, R63.2; also elsewhere on the board
/AV7: R56.1, RN2.3 (R3.1); also elsewhere on the board
/AV7_MCU: R57.1, R62.2; also elsewhere on the board
/AV8: R54.1, RN2.2 (R2.1); also elsewhere on the board
/AV8_MCU: R55.1, R61.2; also elsewhere on the board
/AV9: R7.2, R52.1, RN2.1 (R1.1); also elsewhere on the board
/AV9_MCU: R53.1, R60.2; also elsewhere on the board
/AV10: R34.1, RN4.3 (R3.1); also elsewhere on the board
/AV10_MCU: R32.1, R44.2; also elsewhere on the board
/CAM_MCU: C59.1, D40.4, RN13.5 (R4.2), U46.3 (+); also elsewhere on the board
/CAM_SENSOR: R28.1, RN13.4 (R4.1); also elsewhere on the board
/Vbat_MCU: R74.1, R78.2; also elsewhere on the board
GND: C16.2, C40.2, C45.2, C46.2, C47.2, C48.2, C49.2, C50.2, C51.2, C52.2, C53.2, C54.2, C55.2, C56.2, C57.2, C58.2, C59.2, C79.2, C80.2, C82.2, D13.2, D38.2, D39.2, D40.2, R24.2, R31.2, R34.2, R37.2, R41.2, R52.2, R54.2, R56.2, R58.2, R131.2, R141.2, U8.11 (V-), U35.11 (V-), U36.11 (V-), U46.11 (V-); also elsewhere on the board
unnamed: D29.1 (K), R28.2
unnamed: C16.1, D13.6, RN2.8 (R1.2), U8.5 (+)
unnamed: C45.1, D13.4, RN2.7 (R2.2), U8.3 (+)
unnamed: C46.1, D13.3, RN2.6 (R3.2), U8.12 (+)
unnamed: C47.1, D13.1, RN2.5 (R4.2), U8.10 (+)
unnamed: C52.1, D38.6, RN3.8 (R1.2), U35.5 (+)
unnamed: C53.1, D38.4, RN3.7 (R2.2), U35.3 (+)
unnamed: C54.1, D38.3, RN3.6 (R3.2), U35.12 (+)
unnamed: C55.1, D38.1, RN3.5 (R4.2), U35.10 (+)
unnamed: C48.1, D39.3, RN4.8 (R1.2), U36.12 (+)
unnamed: C49.1, D39.1, RN4.7 (R2.2), U36.10 (+)
unnamed: C50.1, D39.6, RN4.6 (R3.2), U36.5 (+)
unnamed: C51.1, D39.4, RN4.5 (R4.2), U36.3 (+)
unnamed: C56.1, D40.3, RN13.8 (R1.2), U46.12 (+)
unnamed: C57.1, D40.1, RN13.7 (R2.2), U46.10 (+)
unnamed: R139.1, R141.1, RN13.3 (R3.1)
unnamed: C58.1, D40.6, RN13.6 (R3.2), U46.5 (+)
unnamed: R55.2, U8.1, U8.2 (-)
unnamed: R53.2, U8.6 (-), U8.7
unnamed: R59.2, U8.8, U8.9 (-)
unnamed: R57.2, U8.13 (-), U8.14
unnamed: R65.2, U35.1, U35.2 (-)
unnamed: R64.2, U35.6 (-), U35.7
unnamed: R67.2, U35.8, U35.9 (-)
unnamed: R66.2, U35.13 (-), U35.14
unnamed: R35.2, U36.1, U36.2 (-)
unnamed: R32.2, U36.6 (-), U36.7
unnamed: R26.2, U36.8, U36.9 (-)
unnamed: R5.2, U36.13 (-), U36.14
unnamed: R75.2, U46.1, U46.2 (-)
unnamed: R74.2, U46.6 (-), U46.7
unnamed: R73.2, U46.8, U46.9 (-)
unnamed: R72.2, U46.13 (-), U46.14

Notes on the sheet:
Comparator with histeresis for CAM input? Usign this OpAmp.
NOT OEM POPULATED OEM IS AV6 AND AV10 ARE ANALOG AV8 AND AV9 ARE DIGITAL OUTPUTS

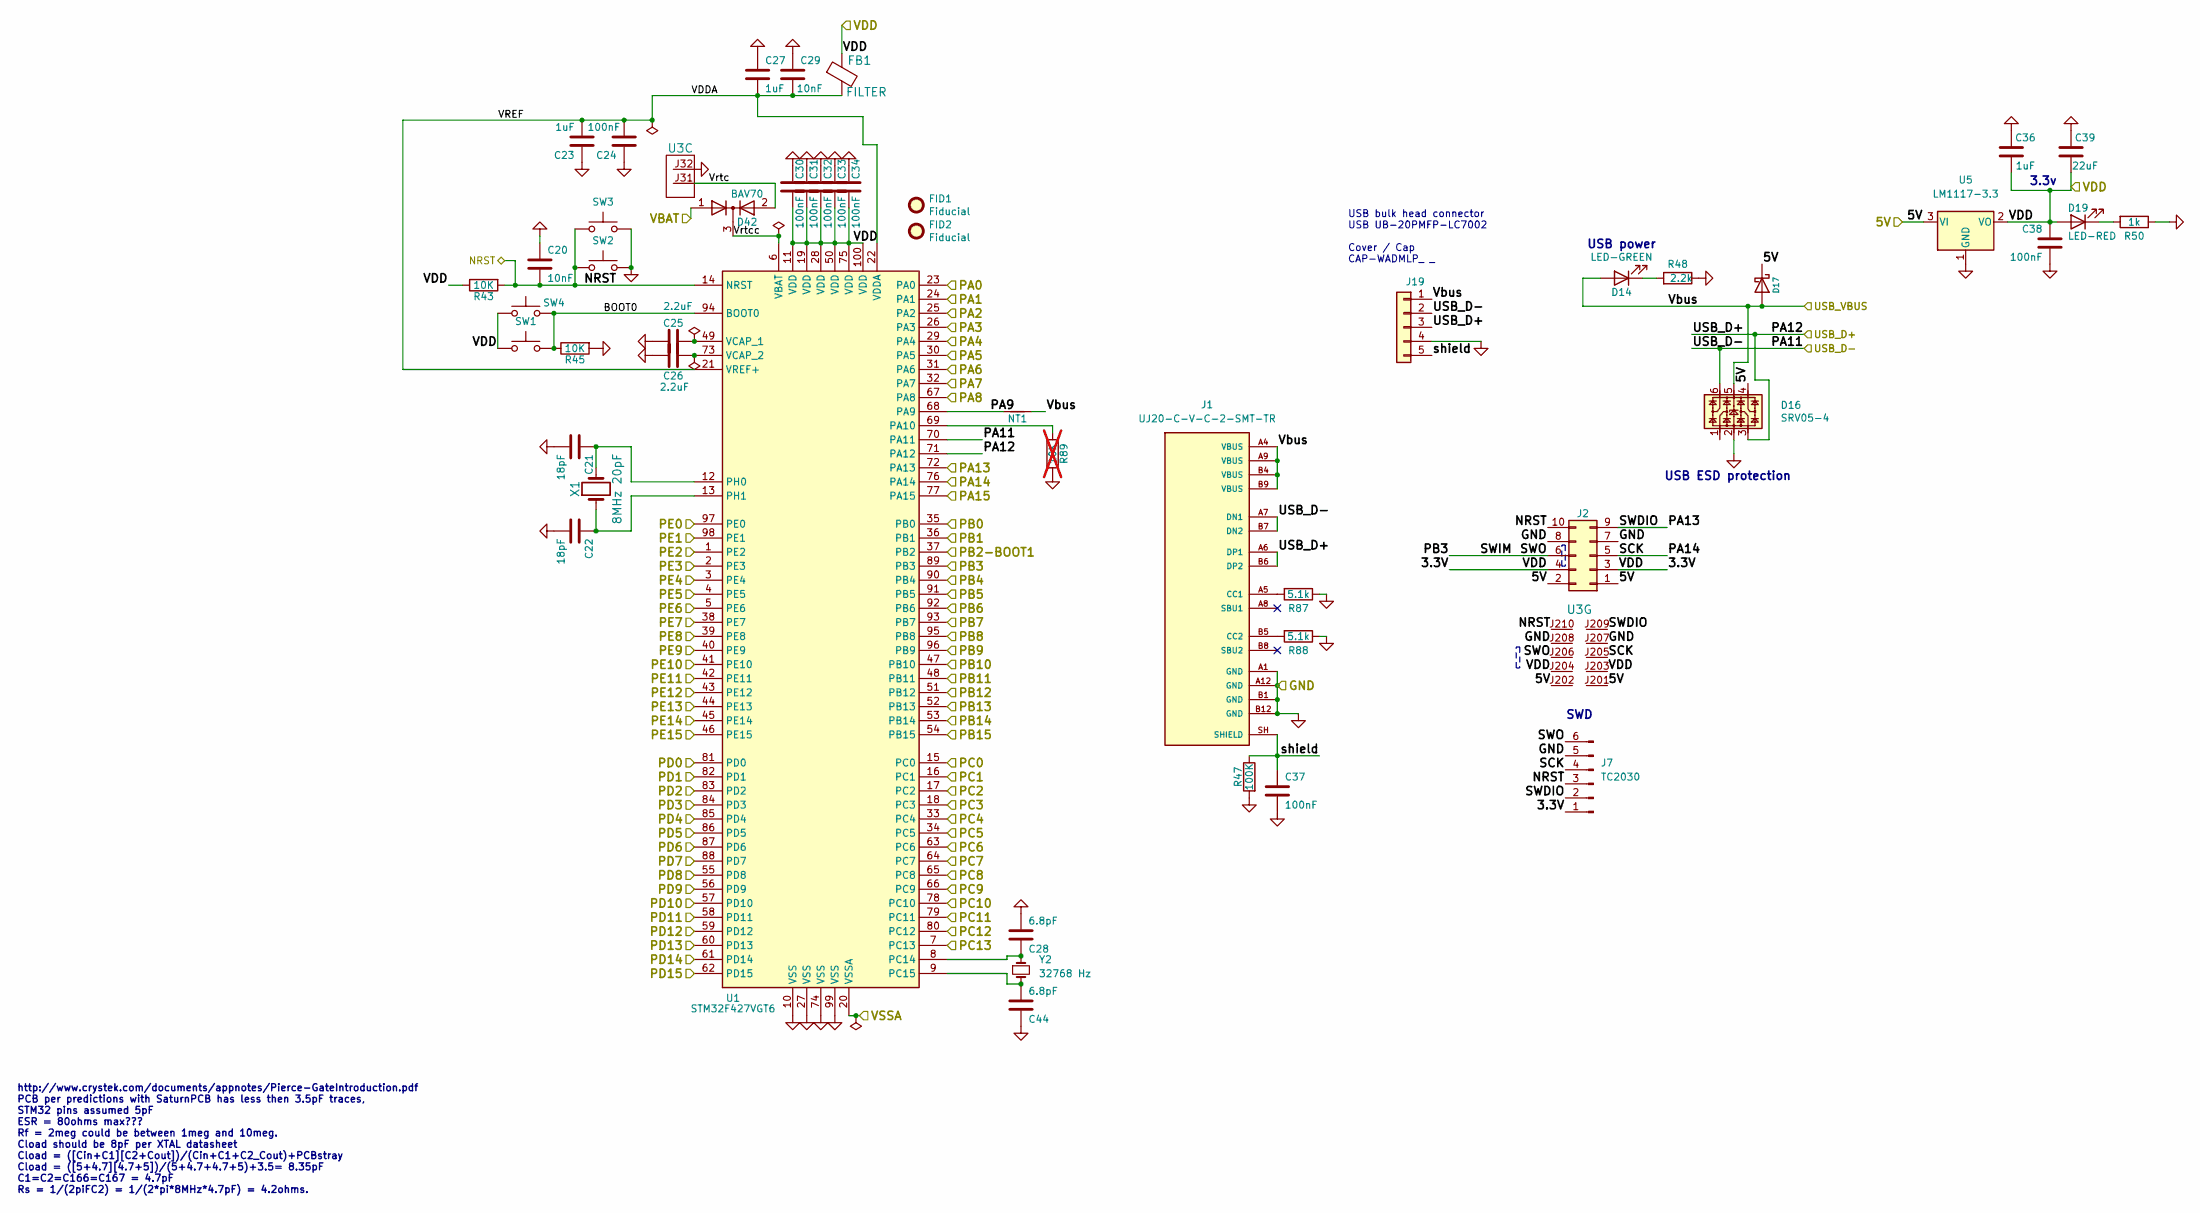
[picture p6: schematic stm32.kicad_sch, microRusEFI-2L]

Parts:
C20, C29: 10nF; C_0603_1608Metric; Part # C0603C103K1RACTU; LCSC C57112
C21, C22: 18pF; C_0603_1608Metric; Part # CL10C180JB8NNNC; LCSC C1647
C23, C27, C36: 1uF; C_0603_1608Metric; Part # UMK107BJ105KA-T; LCSC C15849
C24, C30, C31, C32, C33, C34, C37, C38: 100nF; C_0603_1608Metric; Part # C0603C104J5RACTU; LCSC C14663
C25, C26: 2.2uF; C_0603_1608Metric; Part # GRM188R6YA225KA12D; LCSC C23630
C28, C44: 6.8pF; C_0603_1608Metric; LCSC C1679
C39: 22uF; C_0805_2012Metric; LCSC C59461
D14: LED-GREEN; LED_0805_2012Metric; LCSC C2297
D16: SRV05-4; SOT-23-6; LCSC C85364
D17: B5819W; D_SOD-123; LCSC C8598
D19: LED-RED; LED_0603_1608Metric; LCSC C2286
D42: BAV70; SOT-23; LCSC C82479
FB1: FILTER; R_0603_1608Metric_Pad1.05x0.95mm_HandSolder; Part # BLM21PG221SN1D; LCSC C1034
FID1, FID2: Fiducial; Fiducial_0.5mm_Mask1mm; Part # DNP
J1: UJ20-C-V-C-2-SMT-TR; CUI_UJ20-C-V-C-2-SMT-TR; PARTREV 1.0
J2: Conn_02x05_Odd_Even; PinSocket_2x05_P2.54mm_Vertical_SMD; Part # 95278-801B10LF
J7: TC2030; Tag-Connect_TC2030-IDC-NL_2x03_P1.27mm_Vertical
J19: Conn_01x06; JST_EH_B5B-EH-A_1x05_P2.50mm_Vertical
NT1: Net-Tie_2; Net-Tie_2_8.5mil
R43, R45: 10K; R_0603_1608Metric; Part # RMCF0603JT10K0; LCSC C25804
R47: 100K; R_0603_1608Metric; Part # RMCF0603JT100K; LCSC C25803
R48: 2.2k; R_0603_1608Metric; Part # RMCF0603FT2K20; LCSC C4190
R50: 1k; R_0603_1608Metric; Part # RMCF0603JJ1K00; LCSC C21190
R87, R88: 5.1k; R_0603_1608Metric; Part # RMCF0603JJ1K00; LCSC C21190
R89: 10K; R_0603_1608Metric; Part # RMCF0603JT10K0; LCSC C25804; not fitted
SW1, SW2: SW_Push; SW_SPST_CK_RS282G05A3; LCSC C398054
SW3, SW4: SW_Push; SW_Push_SPST_NO_Alps_SKRK
U1: STM32F427VGT6; LQFP-100_14x14mm_P0.5mm; Part # STM32F427VGT6; LCSC C117815
U3: molex_48pin_MRE
U5: LM1117-3.3; SOT-223-3_TabPin2; LCSC C6186
X1: 8MHz 20pF; Crystal_SMD_5032-2Pin_5.0x3.2mm; LCSC C115962
Y2: 32768 Hz; Crystal_SMD_3215-2Pin_3.2x1.5mm; LCSC C32346

Connections:
/5V: D16.4, D17.1 (K), J2.1, J2.2, U3.J201, U3.J202, U5.3 (VI); also elsewhere on the board
/ADC/AGND: U1.20 (VSSA); also elsewhere on the board
/AT1_MCU: U1.23 (PA0); also elsewhere on the board
/AT2_MCU: U1.24 (PA1); also elsewhere on the board
/AT3_MCU: U1.25 (PA2); also elsewhere on the board
/AT4_MCU: U1.26 (PA3); also elsewhere on the board
/AV1_MCU: U1.15 (PC0); also elsewhere on the board
/AV2_MCU: U1.31 (PA6); also elsewhere on the board
/AV3_MCU: U1.32 (PA7); also elsewhere on the board
/AV4_MCU: U1.17 (PC2); also elsewhere on the board
/AV5_MCU: U1.18 (PC3); also elsewhere on the board
/AV6_MCU: U1.33 (PC4); also elsewhere on the board
/AV7_MCU: U1.34 (PC5); also elsewhere on the board
/AV8_MCU: U1.35 (PB0); also elsewhere on the board
/AV9_MCU: U1.36 (PB1); also elsewhere on the board
/AV10_MCU: U1.29 (PA4); also elsewhere on the board
/CAM_MCU: U1.30 (PA5); also elsewhere on the board
/CRANK: U1.63 (PC6); also elsewhere on the board
/CS_TLE: U1.86 (PD5); also elsewhere on the board
/FlashMemory/CS: U1.46 (PE15); also elsewhere on the board
/FlashMemory/SCK: U1.52 (PB13); also elsewhere on the board
/FlashMemory/SI: U1.54 (PB15); also elsewhere on the board
/FlashMemory/SO: U1.53 (PB14); also elsewhere on the board
/H-BRIDGE/DIR: U1.67 (PA8); also elsewhere on the board
/H-BRIDGE/DIS: U1.65 (PC8); also elsewhere on the board
/H-BRIDGE/PWM: U1.64 (PC7); also elsewhere on the board
/H-BRIDGE/SO: U1.66 (PC9); also elsewhere on the board
/MCU/BOOT0: R45.1, SW1.2, SW4.2, U1.94 (BOOT0)
/MCU/PA9: NT1.1, U1.68 (PA9)
/MCU/PA13: J2.9, J7.2, U1.72 (PA13), U3.J209
/MCU/PA14: J2.5, J7.4, U1.76 (PA14), U3.J205
/MCU/PB2-BOOT1: U1.37 (PB2); also elsewhere on the board
/MCU/PB6: U1.92 (PB6); also elsewhere on the board
/MCU/PB7: U1.93 (PB7); also elsewhere on the board
/MCU/PB12: U1.51 (PB12); also elsewhere on the board
/MCU/PD0: U1.81 (PD0); also elsewhere on the board
/MCU/PD1: U1.82 (PD1); also elsewhere on the board
/MCU/PD2: U1.83 (PD2); also elsewhere on the board
/MCU/PD3: U1.84 (PD3); also elsewhere on the board
/MCU/PD4: U1.85 (PD4); also elsewhere on the board
/MCU/PD6: U1.87 (PD6); also elsewhere on the board
/MCU/PD7: U1.88 (PD7); also elsewhere on the board
/MCU/PD8: U1.55 (PD8); also elsewhere on the board
/MCU/PD9: U1.56 (PD9); also elsewhere on the board
/MCU/PD10: U1.57 (PD10); also elsewhere on the board
/MCU/PD11: U1.58 (PD11); also elsewhere on the board
/MCU/PE5: U1.4 (PE5); also elsewhere on the board
/MCU/PE6: U1.5 (PE6); also elsewhere on the board
/MCU/PE7: U1.38 (PE7); also elsewhere on the board
/MCU/PE8: U1.39 (PE8); also elsewhere on the board
/MCU/PE9: U1.40 (PE9); also elsewhere on the board
/MCU/PE10: U1.41 (PE10); also elsewhere on the board
/MCU/PE11: U1.42 (PE11); also elsewhere on the board
/MCU/PE12: U1.43 (PE12); also elsewhere on the board
/MCU/PE13: U1.44 (PE13); also elsewhere on the board
/MCU/PE14: U1.45 (PE14); also elsewhere on the board
/MCU/VBAT: D42.1 (A); also elsewhere on the board
/MCU/VDDA: C23.2, C24.2, C27.2, C29.2, FB1.2, U1.21 (VREF+), U1.22 (VDDA)
/MCU/Vbus: D14.2 (A), D16.5, D17.2 (A), J1.A4 (VBUS), J1.A9 (VBUS), J1.B4 (VBUS), J1.B9 (VBUS), J19.1, NT1.2; also elsewhere on the board
/MCU/Vrtc: D42.2 (A), U3.J31
/MCU/Vrtcc: D42.3 (K), U1.6 (VBAT)
/MCU/shield: C37.1, J1.SH (SHIELD), J19.5, R47.1
/PA15: U1.77 (PA15); also elsewhere on the board
/PB8: U1.95 (PB8); also elsewhere on the board
/PB9: U1.96 (PB9); also elsewhere on the board
/PB10: U1.47 (PB10); also elsewhere on the board
/PB11: U1.48 (PB11); also elsewhere on the board
/PC10: U1.78 (PC10); also elsewhere on the board
/PC11: U1.79 (PC11); also elsewhere on the board
/PC12: U1.80 (PC12); also elsewhere on the board
/PC13: U1.7 (PC13); also elsewhere on the board
/PD12: U1.59 (PD12); also elsewhere on the board
/PD13: U1.60 (PD13); also elsewhere on the board
/PD14: U1.61 (PD14); also elsewhere on the board
/PD15: U1.62 (PD15); also elsewhere on the board
/PE0: U1.97 (PE0); also elsewhere on the board
/PE1: U1.98 (PE1); also elsewhere on the board
/PE2: U1.1 (PE2); also elsewhere on the board
/PE3: U1.2 (PE3); also elsewhere on the board
/PE4: U1.3 (PE4); also elsewhere on the board
/RST: C20.2, J2.10, J7.3, R43.2, SW2.1, SW3.1, U1.14 (NRST), U3.J210; also elsewhere on the board
/SCK: J2.6, J7.6, U1.89 (PB3), U3.J206; also elsewhere on the board
/SI: U1.91 (PB5); also elsewhere on the board
/SO: U1.90 (PB4); also elsewhere on the board
/USB_D+: D16.3, J1.A6 (DP1), J1.B6 (DP2), J19.3, U1.71 (PA12); also elsewhere on the board
/USB_D-: D16.6, J1.A7 (DN1), J1.B7 (DN2), J19.2, U1.70 (PA11); also elsewhere on the board
/VDD: C30.2, C31.2, C32.2, C33.2, C34.2, C36.2, C38.1, C39.2, D19.2 (A), FB1.1, J2.3, J2.4, J7.1, R43.1, SW1.1, SW4.1, U1.11 (VDD), U1.19 (VDD), U1.28 (VDD), U1.50 (VDD), U1.75 (VDD), U1.100 (VDD), U3.J203, U3.J204, U5.2 (VO); also elsewhere on the board
/Vbat_MCU: U1.16 (PC1); also elsewhere on the board
GND: C20.1, C21.2, C22.2, C23.1, C24.1, C25.2, C26.2, C27.1, C28.2, C29.1, C30.1, C31.1, C32.1, C33.1, C34.1, C36.1, C37.2, C38.2, C39.1, C44.1, D16.2, J1.A1 (GND), J1.A12 (GND), J1.B1 (GND), J1.B12 (GND), J2.7, J2.8, J7.5, J19.4, R45.2, R47.2, R48.1, R50.1, R87.1, R88.1, R89.1, SW2.2, SW3.2, U1.10 (VSS), U1.27 (VSS), U1.74 (VSS), U1.99 (VSS), U3.J32, U3.J207, U3.J208, U5.1 (GND); also elsewhere on the board
unnamed: D14.1 (K), R48.2
unnamed: D19.1 (K), R50.2
unnamed: J1.A5 (CC1), R87.2
unnamed: J1.B5 (CC2), R88.2
unnamed: R89.2, U1.69 (PA10)
unnamed: C28.1, U1.8 (PC14), Y2.1
unnamed: C44.2, U1.9 (PC15), Y2.2
unnamed: C21.1, U1.12 (PH0), X1.2
unnamed: C22.1, U1.13 (PH1), X1.1
unnamed: C25.1, U1.49 (VCAP_1)
unnamed: C26.1, U1.73 (VCAP_2)

Notes on the sheet:
SWD
USB bulk head connector USB UB-20PMFP-LC7002 Cover / Cap CAP-WADMLP_ _
http://www.crystek.com/documents/appnotes/Pierce-GateIntroduction.pdf PCB per predictions with SaturnPCB has less then 3.5pF traces, STM32 pins assumed 5pF ESR = 80ohms max??? Rf = 2meg could be between 1meg and 10meg. Cload should be 8pF per XTAL datasheet Cload = ([Cin+C1][C2+Cout])/(Cin+C1+C2_Co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
3.3v
USB power
USB ESD protection

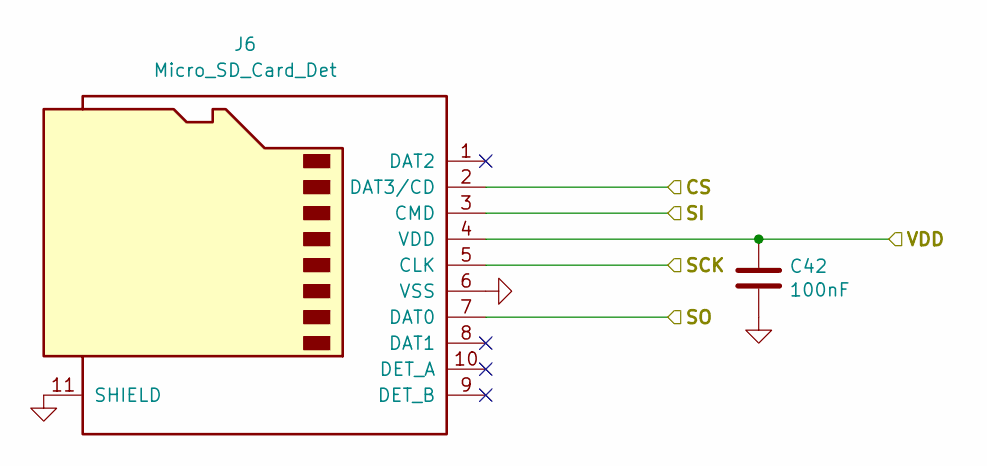
[picture p7: schematic FlashMemory.kicad_sch, microRusEFI-2L]

Parts:
C42: 100nF; C_0603_1608Metric; Part # C0603C104J5RACTU; LCSC C14663
J6: Micro_SD_Card_Det; microSD_HC_Molex_104031-0811; LCSC C585350

Connections:
/FlashMemory/CS: J6.2 (DAT3/CD); also elsewhere on the board
/FlashMemory/SCK: J6.5 (CLK); also elsewhere on the board
/FlashMemory/SI: J6.3 (CMD); also elsewhere on the board
/FlashMemory/SO: J6.7 (DAT0); also elsewhere on the board
/VDD: C42.1, J6.4 (VDD); also elsewhere on the board
GND: C42.2, J6.6 (VSS), J6.11 (SHIELD); also elsewhere on the board

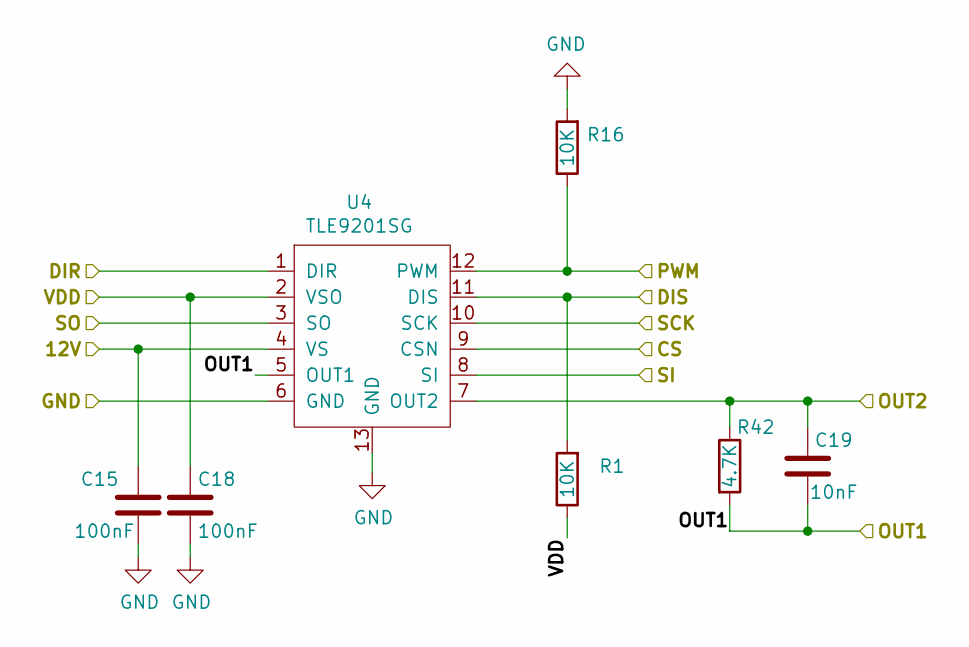
[picture p8: schematic TLE9201SG.kicad_sch, microRusEFI-2L]

Parts:
C15, C18: 100nF; C_0603_1608Metric; Part # C0603C104J5RACTU; LCSC C14663
C19: 10nF; C_0603_1608Metric; Part # C0603C103K1RACTU; LCSC C57112
R1, R16: 10K; R_0603_1608Metric; Part # RMCF0603JT10K0; LCSC C25804
R42: 4.7K; R_0603_1608Metric; Part # RMCF0603JT4K70; LCSC C23162
U4: TLE9201SG; Infineon_PG-DSO-12-11; Part # TLE9201SG; LCSC C112633

Connections:
/12V_MREL: C15.1, U4.4 (VS); also elsewhere on the board
/E-THROTTLE+: C19.2, R42.2, U4.5 (OUT1); also elsewhere on the board
/E-THROTTLE-: C19.1, R42.1, U4.7 (OUT2); also elsewhere on the board
/H-BRIDGE/DIR: U4.1 (DIR); also elsewhere on the board
/H-BRIDGE/DIS: R1.2, U4.11 (DIS); also elsewhere on the board
/H-BRIDGE/PWM: R16.1, U4.12 (PWM); also elsewhere on the board
/H-BRIDGE/SO: U4.3 (SO); also elsewhere on the board
/VDD: C18.1, R1.1, U4.2 (VSO); also elsewhere on the board
GND: C15.2, C18.2, R16.2, U4.6 (GND), U4.8 (SI), U4.9 (CSN), U4.10 (SCK), U4.13 (GND); also elsewhere on the board

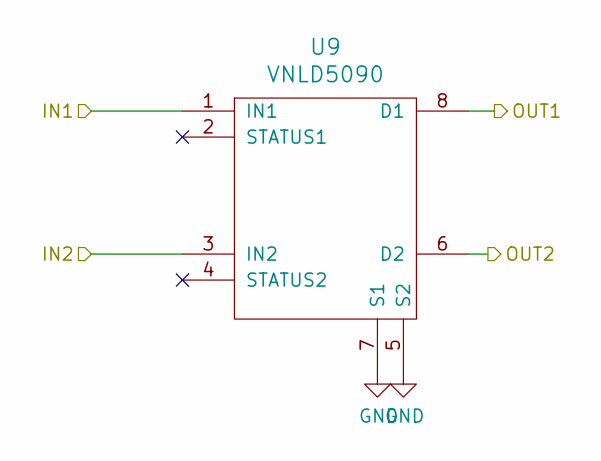
[picture p9: schematic pair.kicad_sch, microRusEFI-2L]

Parts:
U9: VNLD5090; SO-8_3.9x4.9mm_P1.27mm; LCSC C377942

Connections:
/AV6: U9.6 (D2); also elsewhere on the board
/AV10: U9.8 (D1); also elsewhere on the board
/TLE_OUT12_PRE: U9.3 (IN2); also elsewhere on the board
/TLE_OUT13_PRE: U9.1 (IN1); also elsewhere on the board
GND: U9.5 (S2), U9.7 (S1); also elsewhere on the board

Parts of its further copies:
U10: VNLD5090; SO-8_3.9x4.9mm_P1.27mm; LCSC C377942

Connections of its further copies:
/AV8: U10.8 (D1); also elsewhere on the board
/AV9: U10.6 (D2); also elsewhere on the board
/TLE_OUT10_PRE: U10.3 (IN2); also elsewhere on the board
/TLE_OUT11_PRE: U10.1 (IN1); also elsewhere on the board
GND: U10.5 (S2), U10.7 (S1); also elsewhere on the board

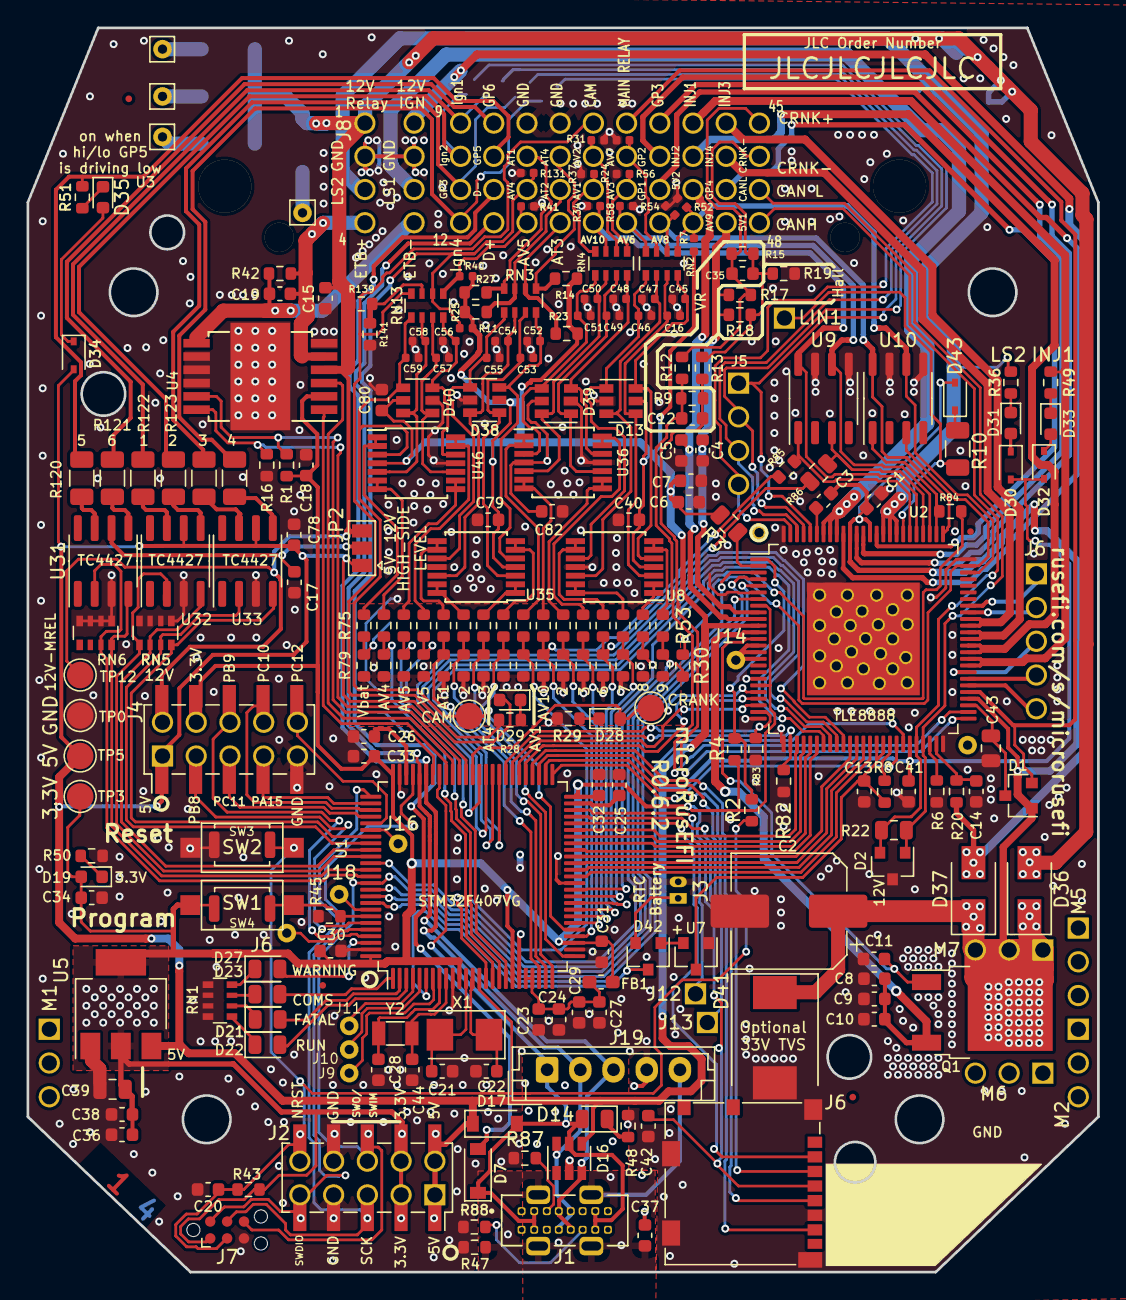
[picture p10: board micro_rusEFI.kicad_pcb from above]

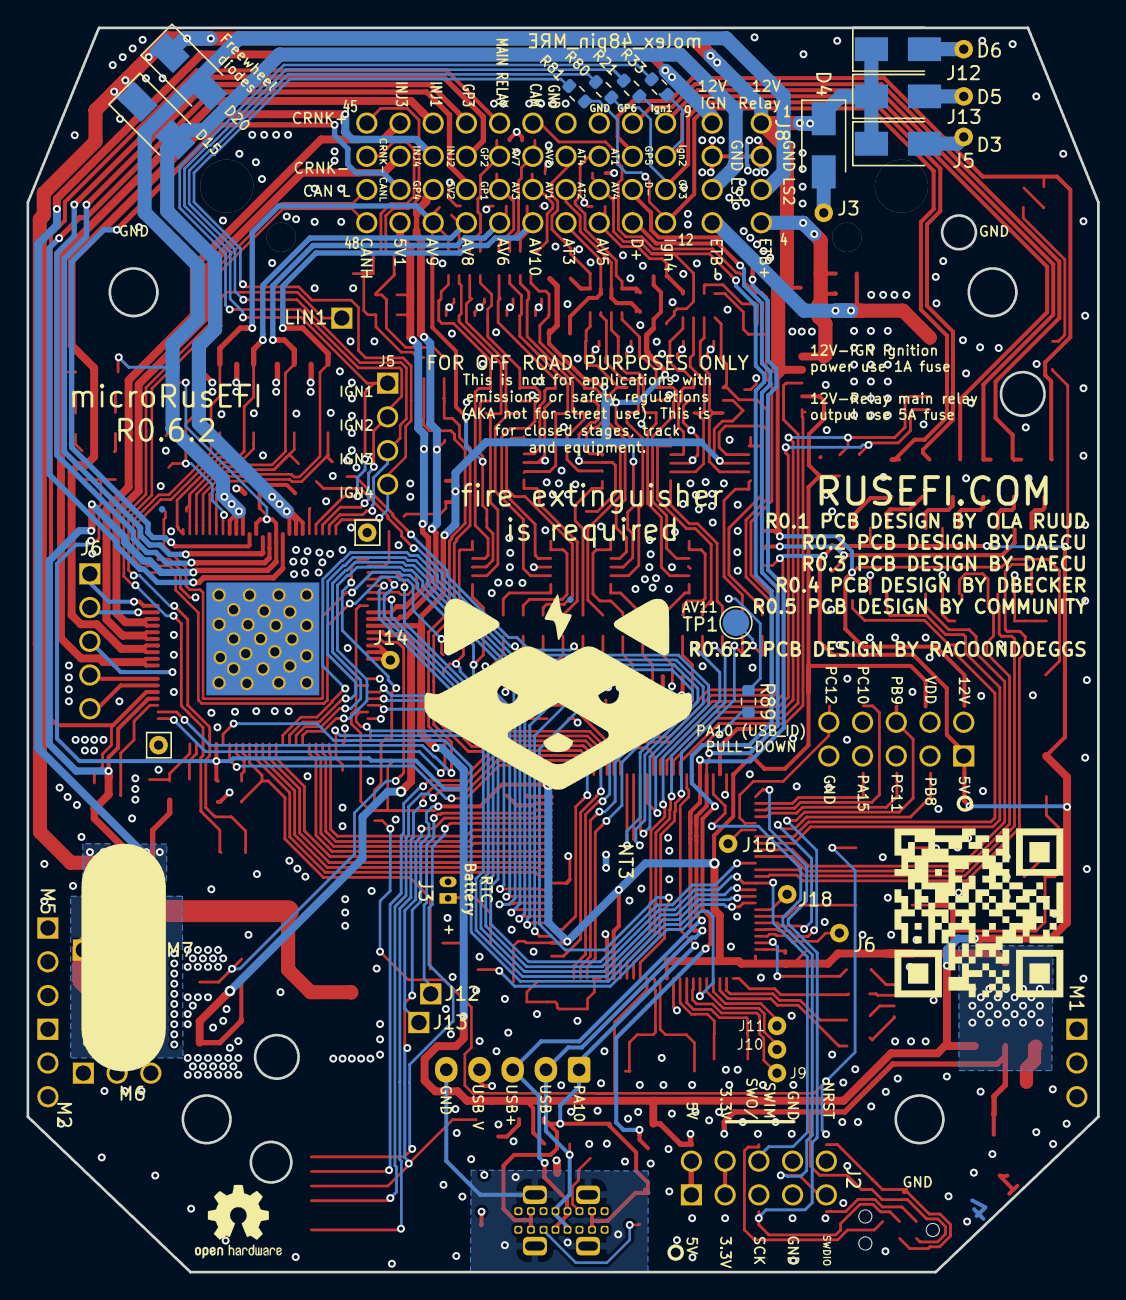
[picture p11: board micro_rusEFI.kicad_pcb from below]

Board: 4 copper layers, 80.6 x 93.7 mm, 257 parts (20 on the bottom side), 227 nets.
