RacoonDOEggs/hw_microRusEfi_usb_c/(commit log)

2025-06-16 replaces micro b connector by usb-c
    [FlashMemory.kicad_sch, TLE8888-1QK.kicad_sch, TLE9201SG.kicad_sch, adc.kicad_sch, hi-lo.kicad_sch, micro_rusEFI.csv, micro_rusEFI.kicad_pcb, micro_rusEFI.kicad_sch]
2025-06-18 Impedence controlled USB traces
    [micro_rusEFI.kicad_pcb]
2025-06-19 widened usb trace to further reduce impedence
    [micro_rusEFI.kicad_pcb, pair.kicad_sch, stm32.kicad_sch]
2025-06-24 completed board, created BOM
    [microRusEFI_R0.6.1_2025-06-23.csv, micro_rusEFI.kicad_pcb, stm32.kicad_sch]
2025-06-24 adjusted BOM and created production files
    [bom.csv, designators.csv, microRusEFI_R0.6.1_2025-06-23.csv, microRusEFI_R0.6.2_2025-06-23.csv, micro_rusEFI.kicad_pcb, positions.csv]
